klonovvladimir/hydrodrive_pcb/outputs/BOM/BOM pirnt.xlsx

Designator | Part Name | Parameters
BUT1_1, BUT1_2, BUT1_3, BUT1_4, BUT1_5, BUT1_6 | Тактовая кнопка KLS7-TS6604-4.3-180 | 4.3мм | 6
C1, C4, C5, C6, C7, C12, C14, C17, C22, C28, C30_1, C30_2, C34, C36, C37, C40, C41, C44, C45, C46, C47 | Конд-р керам. 0805, 0u1, 50V | 0u1, 50V | 21
C2, C3 | Конд-р керам. 0805, 15p, 50V | 15p, 50V | 2
C8, C20, C21, C43 | Конд-р керам. 0805, 10u, 16V | 10u, 16V | 4
C9, C11 | Конд-р керам. 0805, 1u, 50V | 1u, 50V | 2
C10 | Конд-р керам. 0805, 0u01, 50V | 0u01, 50V | 1
C13, C27, C29 | Конд-р электрол. JRB1H471M05001000200000B, 470uF, 50V | 470uF, 50V | 3
C15, C18 | Конд-р керам. 0805, 15n, 50V | 15n, 50V | 2
C16, C19 | Конд-р электрол. JRK1A221M02500630070000B, 220uF, 10V | 220uF, 10V | 2
C23, C25, C31_1, C31_2 | Конд-р электрол. TKR101M1HF11, 100uF, 50V | 100uF, 50V | 4
C24, C26 | Конд-р керам. 1206, 0u1, 50V | 0u1, 50V | 2
C32_1, C32_2, C33_1, C33_2, C33_3, C33_4, C33_5, C33_6, C39_1, C39_2 | Конд-р керам. 0805, 10n, 50V | 10n, 50V | 10
C42 | Конд-р керам. 0805, 1n, 50V | 1n, 50V | 1
C48 | Конд-р керам. 0805, 1n5, 50V | 1n5, 50V | 1
D1, D2, D9 | Диод Шоттки SK56 | 60V, 5A | 3
D3_1, D3_2, D3_3, D3_4, D3_5, D3_6, D15 | Оптопара транзисторная LTV-817S |  | 7
D4, D7 | Диод Шоттки SS24 | 40V, 2A | 2
D5, D8 | Защитный диод SMAJ12A | 12V, 400W | 2
D6 | MOSFET драйвер FAN3224TMX | 4.5..18V, 5A, LL | 1
D10_1, D10_2 | Передатчик 4-20mA AD694ARZ |  | 2
D11_1, D11_2, D12_1, D12_2, D12_3, D12_4, D12_5, D12_6, D16_1, D16_2 | Защитный диод SMBJ3V3-E3/52 | 3V3, 600W | 10
D13 | Микросхема SP3485EN-L/TR | 3V3 | 1
D14 | Микросхема CA-IF1051VS-Q1 | CAN | 1
D17, D18 | Микросхема ADM3490 | 3V3 | 2
D19 | Микросхема P82B715TD | I2C | 1
D20 | Диод Шоттки MBR0540 | 40V, 0.5A | 1
DL1, DL2, DL3, DL4 | Светодиод smd 0805 | Желтый | 4
J1, J4, J5, J6, J10_1, J10_2, J10_3, J10_4, J10_5, J10_6, J15 | Клеммник DG142V-5.08-02P | 8А | 11
J2, J11, J13, J17 | Клеммник DG142V-5.08-03P | 8А | 4
J7, J18, J19, J20, J21, J24, J25 | Разъем PLS-2, шаг 2.54 мм | 2.54 мм | 7
J8 | Разъем PBD-8R, шаг 2.54 мм | 2.54 мм | 1
J9_1, J9_2 | Клеммник DG142V-5.08-06P | 8А | 2
J12, J14, J16_1, J16_2, J22 | Клеммник DG142V-5.08-04P | 8А | 5
J23 | Клеммник DG142V-5.08-08P | 8А | 1
L1 | Индуктивность smd 0805 | 1u, 100mA | 1
L2, L3, L4 | Индуктивность IHLP4040DZER470M11 | 47uH | 3
M1 | Программатор ST-LINK/V2 (mini) Waveshare 10053 |  | 1
OA1 | Операционный усилитель LMV358IDR |  | 1
R1 | Рез-р 0805, 0R, 5% | 0R, 5% | 1
R2, R5, R24_1, R24_2 | Рез-р 0805, 30k, 5% | 30k, 5% | 4
R3, R7_1, R7_2, R7_3, R7_4, R7_5, R7_6, R8_1, R8_2, R8_3, R8_4, R8_5, R8_6, R9, R12, R13, R14, R17, R18, R19, R25_1, R25_2, R33, R35, R36, R38, R39, R41, R45, R46, R47, R48, R49, R50 | Рез-р 0805, 10k, 5% | 10k, 5% | 34
R6 | Рез-р 0805, 18k, 5% | 18k, 5% | 1
R10, R11 | Рез-р 0805, 18R, 5% | 18R, 5% | 2
R15 | Рез-р 1206, 4k7, 5% | 4k7, 5% | 1
R16 | Рез-р 2512, 0R1, 5% | 0R1, 5% | 1
R20, R22 | Рез-р 0805, 510R, 5% | 510R, 5% | 2
R21, R23 | Рез-р 0805, 51k, 5% | 51k, 5% | 2
R26_1, R26_2, R27_1, R27_2, R27_3, R27_4, R27_5, R27_6, R37_1, R37_2 | Рез-р 0805, 120R, 1% | 120R, 1% | 10
R28, R30, R51, R52 | Рез-р 1206, 680R, 5% | 680R, 5% | 4
R29, R32, R53 | Рез-р 1206, 120R, 5% | 120R, 5% | 3
R31, R34 | Рез-р 1206, 0R, 5% | 0R, 5% | 2
R40 | Рез-р 0805, 1k5, 5% | 1k5, 5% | 1
R43 | Рез-р 0805, 15k, 5% | 15k, 5% | 1
R44, R54, R57 | Рез-р 0805, 1k, 5% | 1k, 5% | 3
R55, R56, R58, R59, R60, R61, R62, R63 | Рез-р 0805, 4k7, 5% | 4k7, 5% | 8
R64, R65 | Рез-р 0805, 470R, 5% | 470R, 5% | 2
R68 | Рез-р 0805, 22k, 5% | 22k, 5% | 1
U1 | STM32G474RET6 |  | 1
U2, U3, U5L60B60A60:R6A60:F60 | DC-DC преобразователь LM2596S-ADJ | 40V, 1.23..37V, 3A, 150kHz | 3
U4 | Линейный регулятор LM1117MPX-3.3/NOPB | 3.3V, 800mA | 1
U6, U7, U9, U10, U11, U12 | Диодная сборка USBLC6-2SC6 | 5.25V | 6
U8 | Микросхема REF192GSZ | 2.5V, 0.4% | 1
VT1, VT2 | Транзистора 20N06 | 60V, 20A | 2
VT3, VT4, VT5 | Транзистор BC817 | 45V, 0.5A | 3
VT6 | Транзистор BC807 | 45V, 0.5A | 1
ZQ1 | Кварц. Рез-р HC-49S, 12MHz | 12MHz | 1
