klonovvladimir/hydrodrive_pcb/outputs/BOM/Bill of Materials-gydrodrive_control_board.xlsx

Part Name | Comment | Description | Designator | Parameters | Quantity
 | STM32G474RETx | Mainstream Arm Cortex-M4 core with DSP and FPU, 170MHz with 512Kbytes of Flash memory, Math Accelerator, HR Timer, High Analog level integration | U1 |  | 1
DC-DC преобразователь LM2596S-ADJ | LM2596S-ADJ | DC-DC преобразователь | U2, U3, U5 | 40V, 1.23..37V, 3A, 150kHz | 3
MOSFET драйвер FAN3224TMX | FAN3224TMX | Сдвоенный драйвер ключей нижнего уровня | D6 | 4.5..18V, 5A, LL | 1
Диод Шоттки MBR0540 | MBR0540 | Диод Шоттки | D20 | 40V, 0.5A | 1
Диод Шоттки SK56 | SK56 | Диод Шоттки | D1, D2, D9 | 60V, 5A | 3
Диод Шоттки SS24 | SS24 | Диод Шоттки | D4, D7 | 40V, 2A | 2
Диодная сборка USBLC6-2SC6 | USBLC6-2SC6 | Диодная сборка для защиты дифференциальной линии | U6, U7, U9, U10, U11, U12 | 5.25V | 6
Защитный диод SMAJ12A | SMAJ12A | Защитный диод (TVS) | D5, D8 | 12V, 400W | 2
Защитный диод SMBJ3V3-E3/52 | SMBJ3V3-E3/52 | Защитный диод (TVS) | D11_1, D11_2, D12_1, D12_2, D12_3, D12_4, D12_5, D12_6, D16_1, D16_2 | 3V3, 600W | 10
Индуктивность IHLP4040DZER470M11 | IHLP4040DZER470M11 | Индуктивность силовая | L2, L3, L4 | 47uH | 3
Индуктивность smd 0805 | IND_0805 | Индуктивность, корпус 0805 | L1 | 1u, 100mA | 1
Кварц. Рез-р HC-49S, 12MHz | QRZ_HC_49_SMD | Кварцевый резонатор в корпусе HC-49 SMD | ZQ1 | 12MHz | 1
Клеммник DG142V-5.08-02P | DG142V-5.08-02P | Клеммник 2-контактный, шаг 5.08 мм | J1, J3_1, J3_2, J3_3, J3_4, J3_5, J3_6, J4, J5, J6, J10_1, J10_2, J10_3, J10_4, J10_5, J10_6, J15 | 8А | 17
Клеммник DG142V-5.08-03P | DG142V-5.08-03P | Клеммник 3-контактный, шаг 5.08 мм | J2, J11, J13, J17 | 8А | 4
Клеммник DG142V-5.08-04P | DG142V-5.08-04P | Клеммник 4-контактный, шаг 5.08 мм | J12, J14, J16_1, J16_2, J22 | 8А | 5
Клеммник DG142V-5.08-06P | DG142V-5.08-06P | Клеммник 6-контактный, шаг 5.08 мм | J9_1, J9_2 | 8А | 2
Клеммник DG142V-5.08-08P | DG142V-5.08-08P | Клеммник 8-контактный, шаг 5.08 мм | J23 | 8А | 1
Конд-р керам. 0805, 0u1, 50V | CAP_0805 | Конденсатор керамический, корпус 0805 | C1, C4, C5, C6, C7, C12, C14, C17, C22, C28, C30_1, C30_2, C34, C36, C37, C40, C41, C44, C45, C46, C47 | 0u1, 50V | 21
Конд-р керам. 0805, 0u01, 50V | CAP_0805 | Конденсатор керамический, корпус 0805 | C10 | 0u01, 50V | 1
Конд-р керам. 0805, 1n5, 50V | CAP_0805 | Конденсатор керамический, корпус 0805 | C48 | 1n5, 50V | 1
Конд-р керам. 0805, 1n, 50V | CAP_0805 | Конденсатор керамический, корпус 0805 | C42 | 1n, 50V | 1
Конд-р керам. 0805, 1u, 50V | CAP_0805 | Конденсатор керамический, корпус 0805 | C9, C11 | 1u, 50V | 2
Конд-р керам. 0805, 10n, 50V | CAP_0805 | Конденсатор керамический, корпус 0805 | C32_1, C32_2, C33_1, C33_2, C33_3, C33_4, C33_5, C33_6, C39_1, C39_2 | 10n, 50V | 10
Конд-р керам. 0805, 10u, 16V | CAP_0805 | Конденсатор керамический, корпус 0805 | C8, C20, C21, C43 | 10u, 16V | 4
Конд-р керам. 0805, 15n, 50V | CAP_0805 | Конденсатор керамический, корпус 0805 | C15, C18 | 15n, 50V | 2
Конд-р керам. 0805, 15p, 50V | CAP_0805 | Конденсатор керамический, корпус 0805 | C2, C3 | 15p, 50V | 2
Конд-р керам. 1206, 0u1, 50V | CAP_1206 | Конденсатор керамический, корпус 1206 | C24, C26 | 0u1, 50V | 2
Конд-р керам. 1206, 4n7, 50V | CAP_1206 | Конденсатор керамический, корпус 1206 | C35, C38 | 4n7, 50V | 2
Конд-р электрол. JRB1H471M05001000200000B, 470uF, 50V | JRB1H471M05001000200000B | Конденсатор электролитический | C13, C27, C29 | 470uF, 50V | 3
Конд-р электрол. JRK1A221M02500630070000B, 220uF, 10V | JRK1A221M02500630070000B | Конденсатор электролитический | C16, C19 | 220uF, 10V | 2
Конд-р электрол. TKR101M1HF11, 100uF, 50V | TKR101M1HF11 | Конденсатор электролитический | C23, C25, C31_1, C31_2 | 100uF, 50V | 4
Линейный регулятор LM1117MPX-3.3/NOPB | LM1117MPX-3.3/NOPB | Линейный регулятор с низким падением напряжения | U4 | 3.3V, 800mA | 1
Микросхема ADM3490 | ADM3490 | Дифференциальный приемопередатчик rs422 | D17, D18 | 3V3 | 2
Микросхема CA-IF1051VS-Q1 | CA-IF1051VS-Q1 | CAN интерфейс | D14 | CAN | 1
Микросхема P82B715TD | P82B715TD | Расширитель порта I2C | D19 | I2C | 1
Микросхема REF192GSZ | REF192GSZ | Источник опорного напряжения, 2.5 В | U8 | 2.5V, 0.4% | 1
Микросхема SP3485EN-L/TR | SP3485EN-L/TR | Дифференциальный приемопередатчик rs485 | D13 | 3V3 | 1
Операционный усилитель LMV358IDR | LMV358IDR | Операционный усилитель RTR, маломощный, 2 канала | OA1 |  | 1
Оптопара транзисторная LTV-817S | LTV-817S | Оптопара транзисторная одноканальная | D3_1, D3_2, D3_3, D3_4, D3_5, D3_6, D15 |  | 7
Передатчик 4-20mA AD694ARZ | AD694ARZ |  | D10_1, D10_2 |  | 2
Программатор ST-LINK/V2 (mini) Waveshare 10053 | ST-LINK/V2 | Программатор | M1 |  | 1
Разъем PBD-8R, шаг 2.54 мм | PBD-2.54-08R | Разъем | J8 | 2.54 мм | 1
Разъем PLS-2, шаг 2.54 мм | PLS-2.54-2 JUMP | Разъем штыревой шаг 2.54 мм | J7, J18, J19, J20, J21, J24, J25 | 2.54 мм | 7
Рез-р 0805, 0R, 5% | RES_0805 | Рез-р, корпус 0805 | R1, R4, R42, R66, R67 | 0R, 5% | 5
Рез-р 0805, 1k5, 5% | RES_0805 | Рез-р, корпус 0805 | R40 | 1k5, 5% | 1
Рез-р 0805, 1k, 5% | RES_0805 | Рез-р, корпус 0805 | R44, R54, R57 | 1k, 5% | 3
Рез-р 0805, 4k7, 5% | RES_0805 | Рез-р, корпус 0805 | R55, R56, R58, R59, R60, R61, R62, R63 | 4k7, 5% | 8
Рез-р 0805, 10k, 5% | RES_0805 | Рез-р, корпус 0805 | R3, R7_1, R7_2, R7_3, R7_4, R7_5, R7_6, R8_1, R8_2, R8_3, R8_4, R8_5, R8_6, R9, R12, R13, R14, R17, R18, R19, R25_1, R25_2, R33, R35, R36, R38, R39, R41, R45, R46, R47, R48, R49, R50 | 10k, 5% | 34
Рез-р 0805, 15k, 5% | RES_0805 | Рез-р, корпус 0805 | R43 | 15k, 5% | 1
Рез-р 0805, 18k, 5% | RES_0805 | Рез-р, корпус 0805 | R6 | 18k, 5% | 1
Рез-р 0805, 18R, 5% | RES_0805 | Рез-р, корпус 0805 | R10, R11 | 18R, 5% | 2
Рез-р 0805, 22k, 5% | RES_0805 | Рез-р, корпус 0805 | R68 | 22k, 5% | 1
Рез-р 0805, 30k, 5% | RES_0805 | Рез-р, корпус 0805 | R2, R5, R24_1, R24_2 | 30k, 5% | 4
Рез-р 0805, 51k, 5% | RES_0805 | Рез-р, корпус 0805 | R21, R23 | 51k, 5% | 2
Рез-р 0805, 120R, 1% | RES_0805 | Рез-р, корпус 0805 | R26_1, R26_2, R27_1, R27_2, R27_3, R27_4, R27_5, R27_6, R37_1, R37_2 | 120R, 1% | 10
Рез-р 0805, 470R, 5% | RES_0805 | Рез-р, корпус 0805 | R64, R65 | 470R, 5% | 2
Рез-р 0805, 510R, 5% | RES_0805 | Рез-р, корпус 0805 | R20, R22 | 510R, 5% | 2
Рез-р 1206, 0R, 5% | RES_1206 | Рез-р, корпус 1206 | R31, R34 | 0R, 5% | 2
Рез-р 1206, 4k7, 5% | RES_1206 | Рез-р, корпус 1206 | R15 | 4k7, 5% | 1
Рез-р 1206, 120R, 5% | RES_1206 | Рез-р, корпус 1206 | R29, R32, R53 | 120R, 5% | 3
Рез-р 1206, 680R, 5% | RES_1206 | Рез-р, корпус 1206 | R28, R30, R51, R52 | 680R, 5% | 4
Рез-р 2512, 0R1, 5% | RES_2512 | Рез-р, корпус 2512 | R16 | 0R1, 5% | 1
Светодиод smd 0805 | LED_0805 | Светодиод smd, корпус 0805 | DL1, DL2, DL3, DL4 | Желтый | 4
Тактовая кнопка KLS7-TS6604-4.3-180 | KLS7-TS6604-4.3-180 | Тактовая кнопка SMD | BUT1_1, BUT1_2, BUT1_3, BUT1_4, BUT1_5, BUT1_6 | 4.3мм | 6
Транзистор BC807 | BC807 | Биполярный транзистор | VT6 | 45V, 0.5A | 1
Транзистор BC817 | BC817 | Биполярный транзистор | VT3, VT4, VT5 | 45V, 0.5A | 3
Транзистора 20N06 | 20N06 | Полевой транзистор | VT1, VT2 | 60V, 20A | 2
