klonovvladimir/hydrodrive_pcb/outputs/Схема/Схема электрическая.PDF

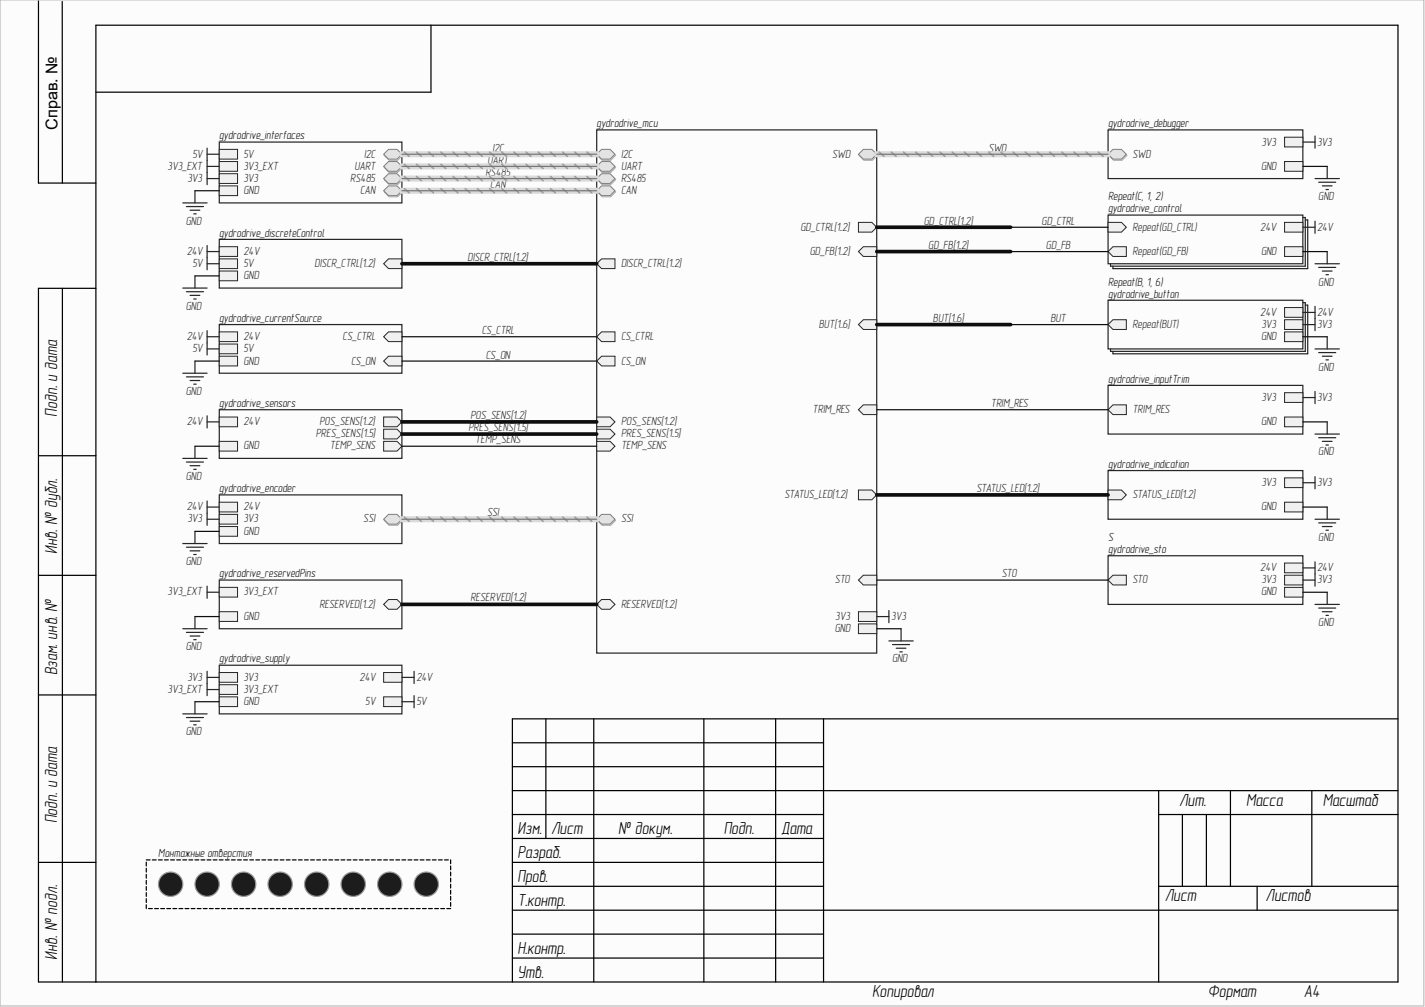
[picture p1: page 1]

Инв. № дубл. Подп. и дата

Инв. № подл. Подп. и дата Взам. инв. №

Лит. | Масса | Масштаб

Изм. | Лист | № докум. | Подп. | Дата
Разраб.
Пров.
Т.контр. | | | | | Лист | Листов

Н.контр.
Утв.

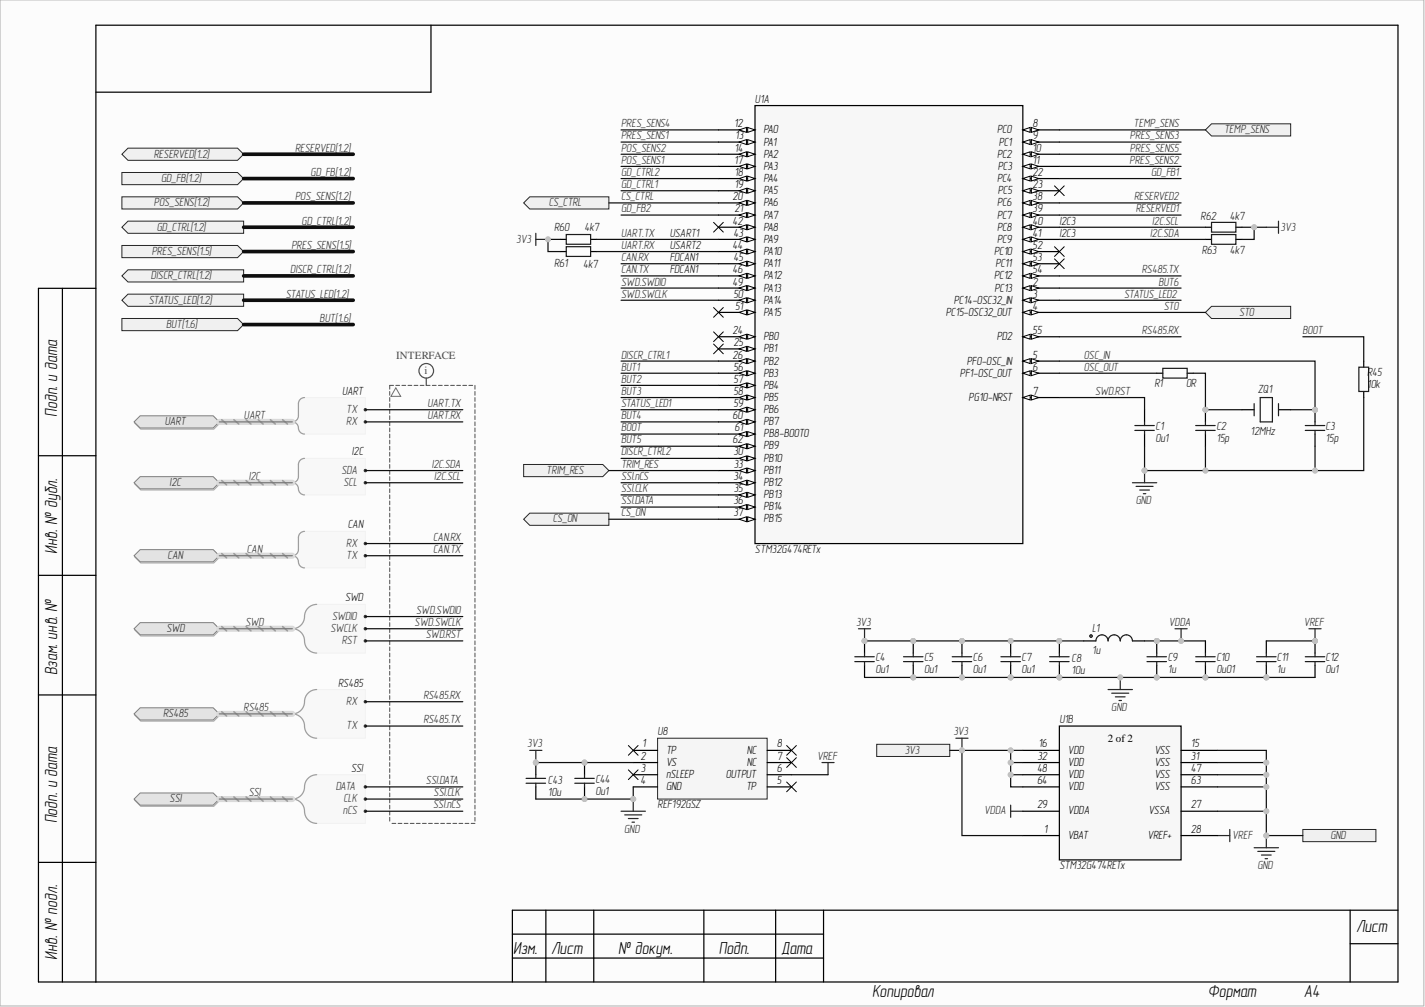
[picture p2: page 2]

Инв. № дубл. Подп. и дата

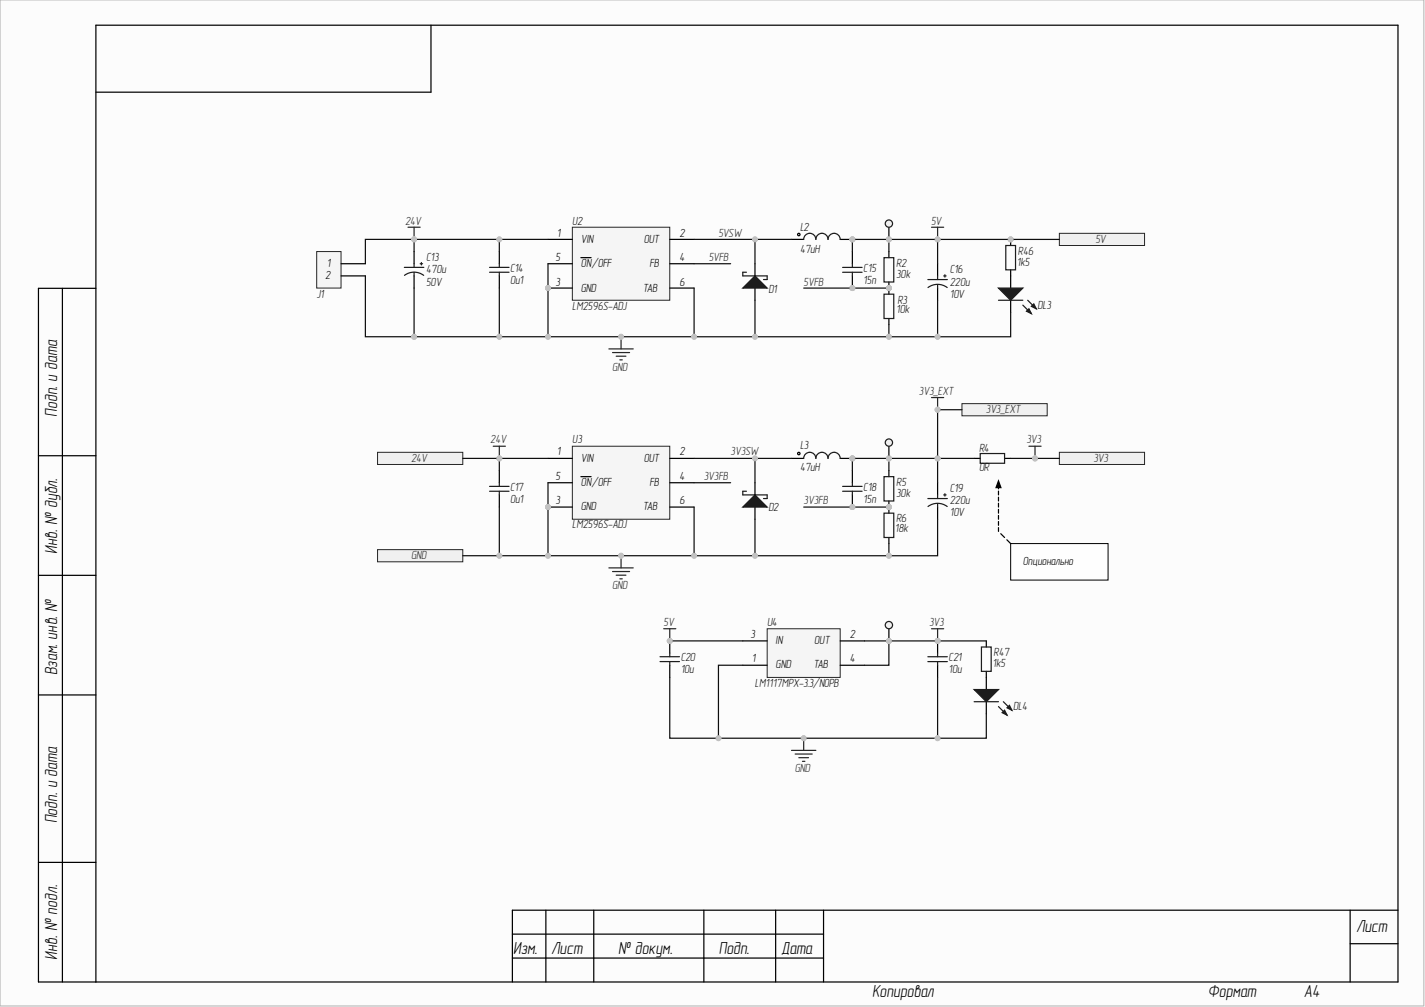
[picture p3: page 3]

Инв. № дубл. Подп. и дата

LM1117MPX-3.3/NOPB

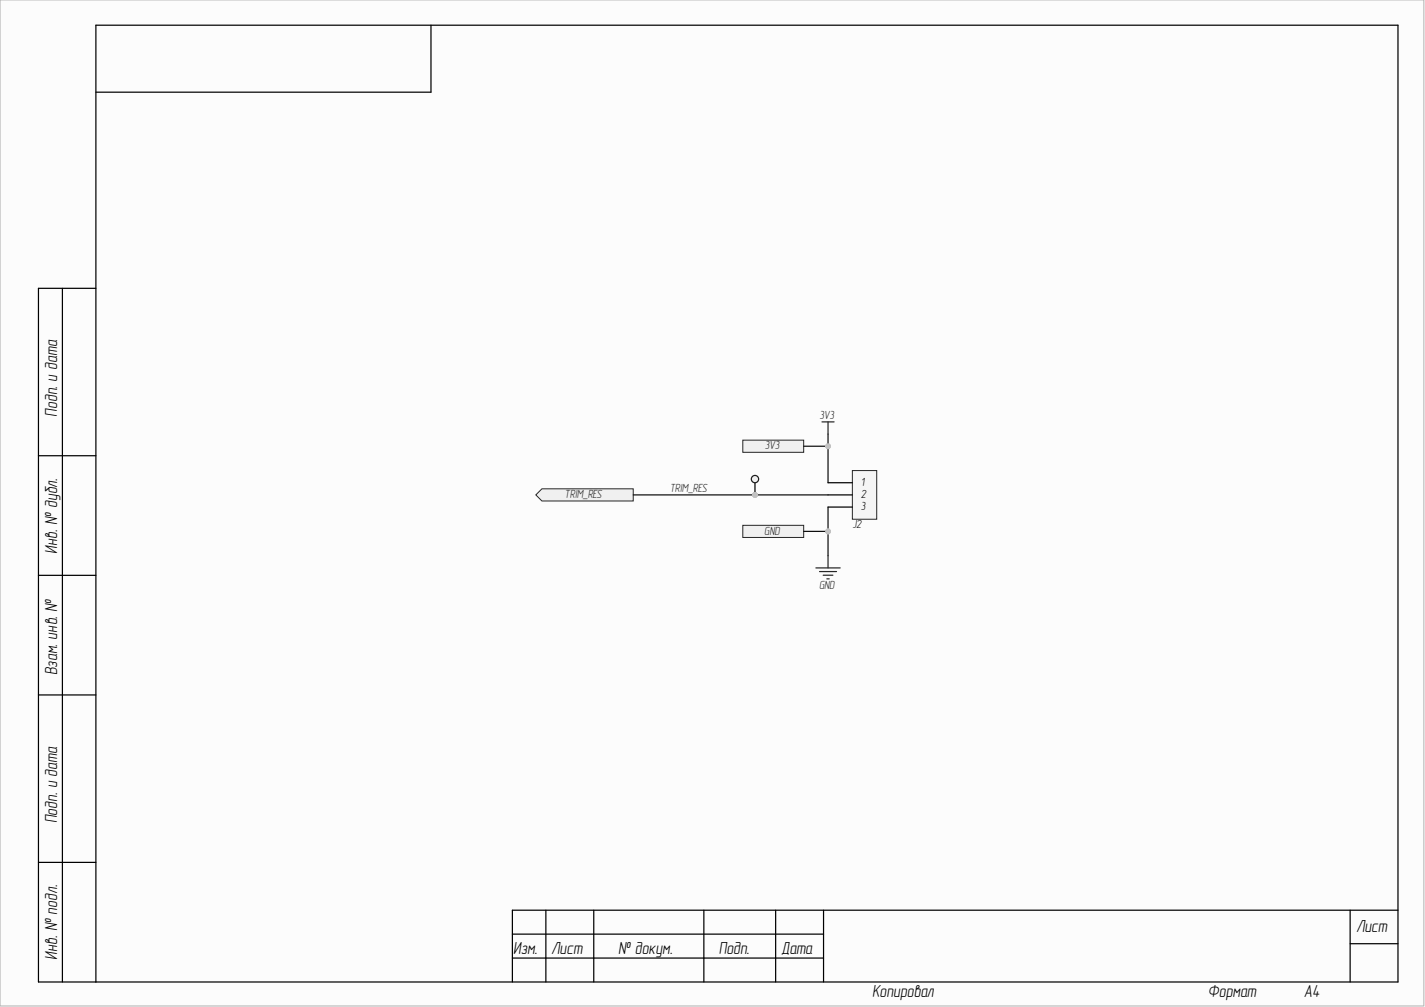
[picture p4: page 4]

Инв. № дубл. Подп. и дата

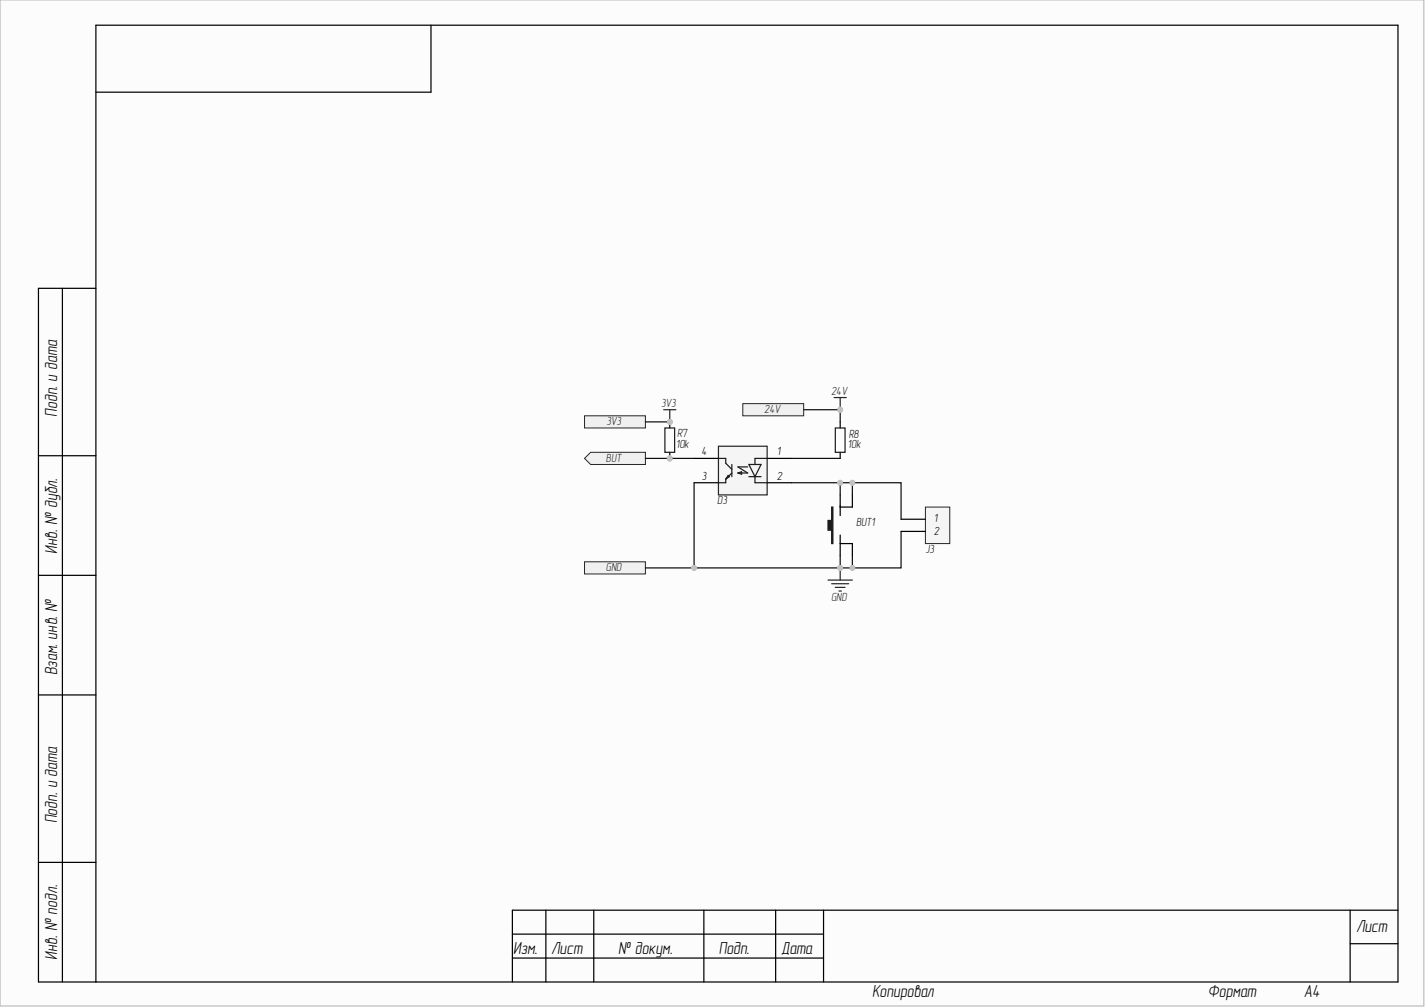
[picture p5: page 5]

Инв. № дубл. Подп. и дата

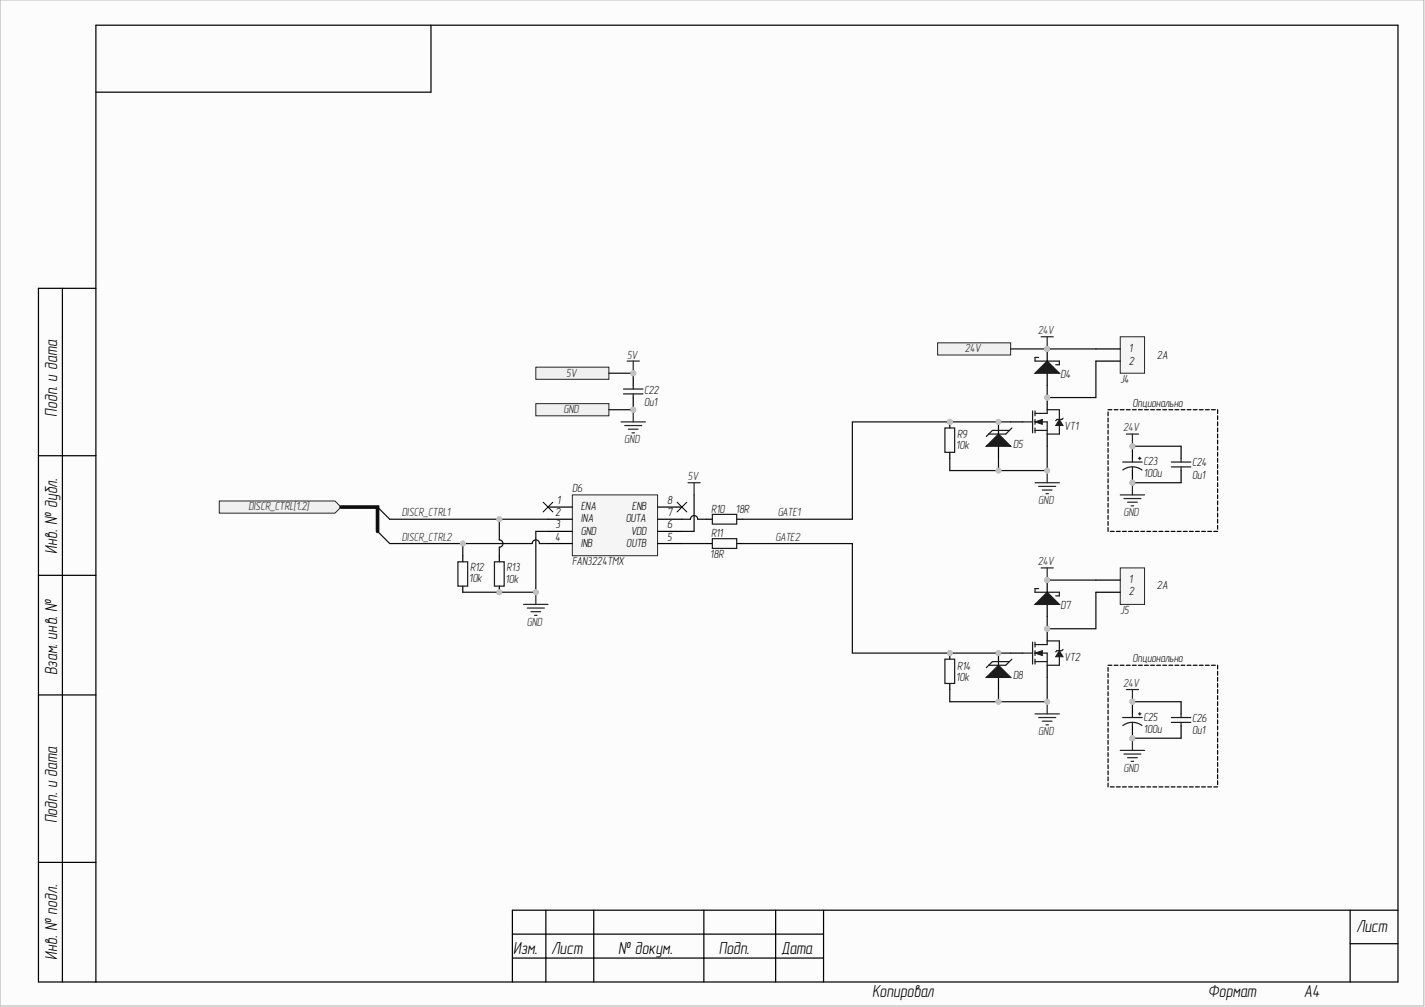
[picture p6: page 6]

Инв. № дубл. Подп. и дата

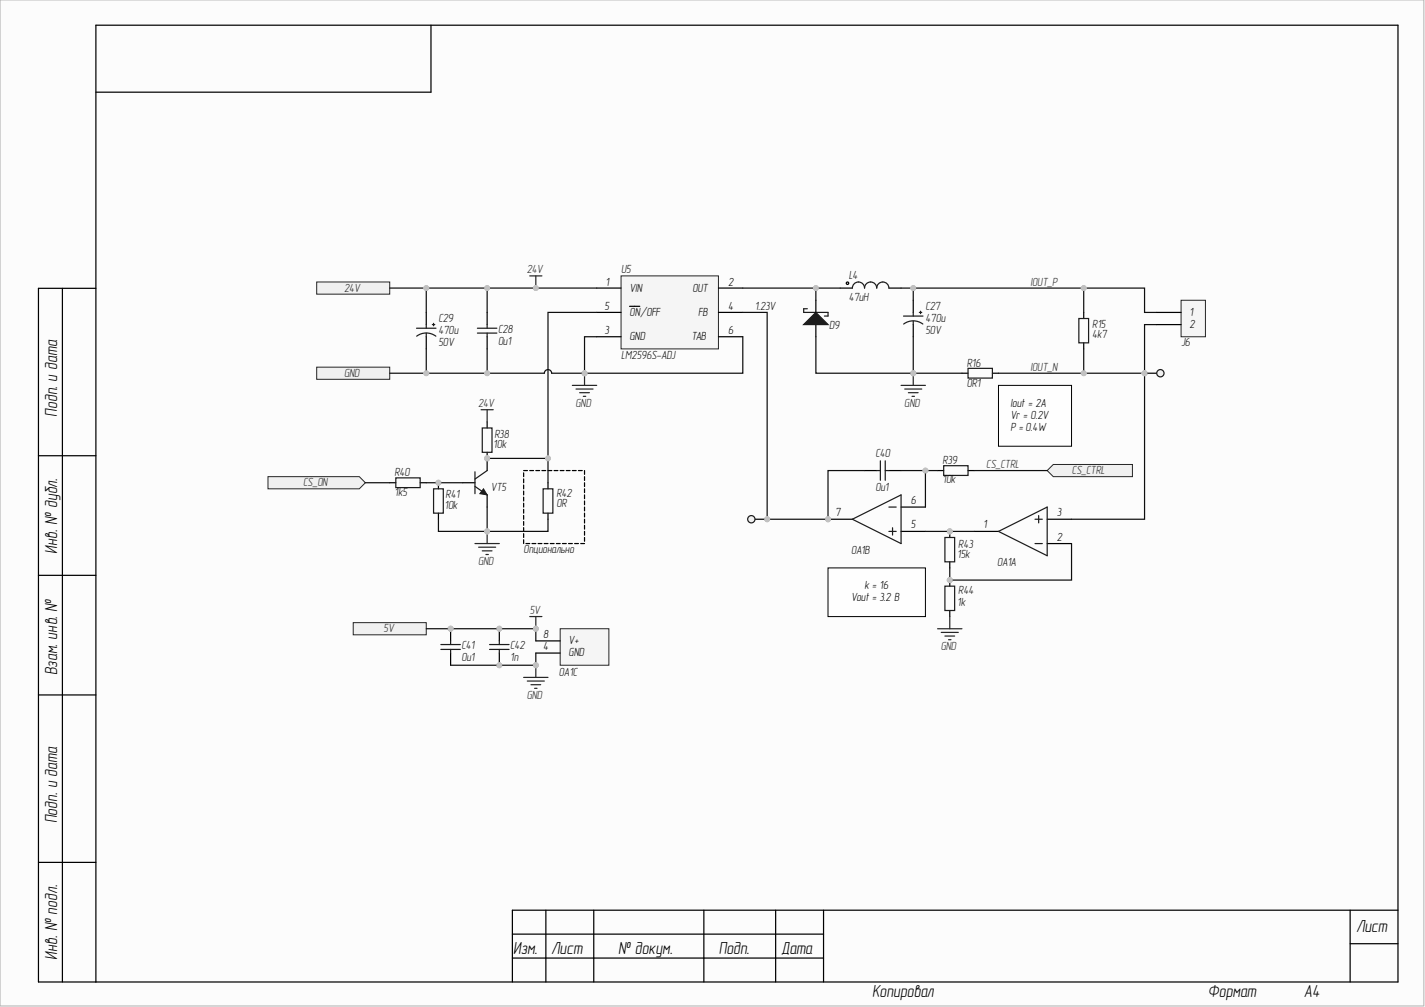
[picture p7: page 7]

Инв. № дубл. Подп. и дата

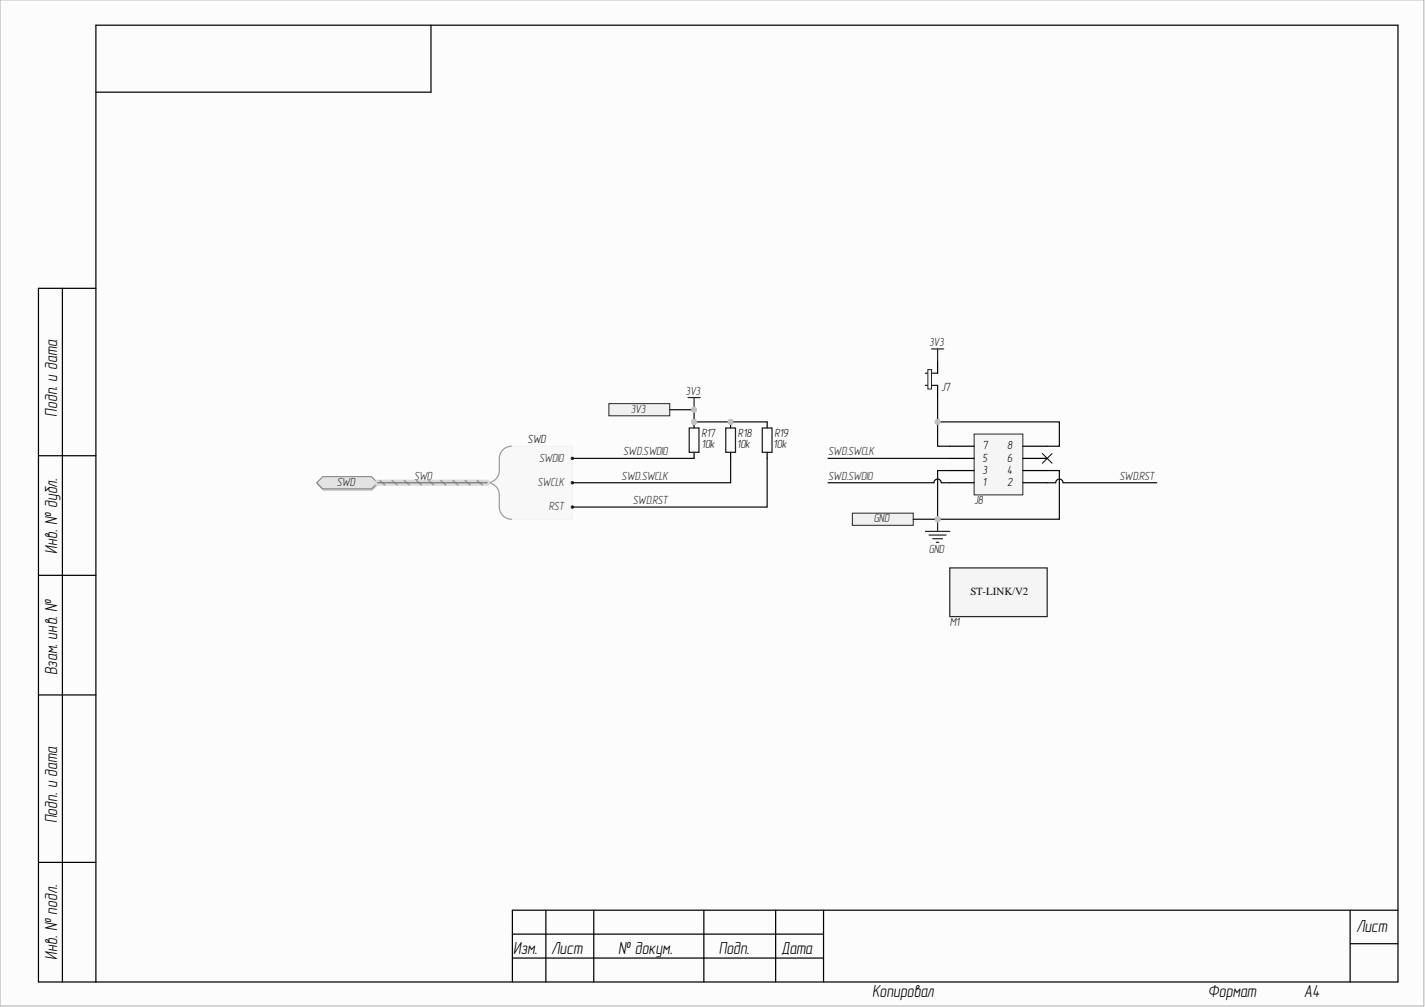
[picture p8: page 8]

Инв. № дубл. Подп. и дата

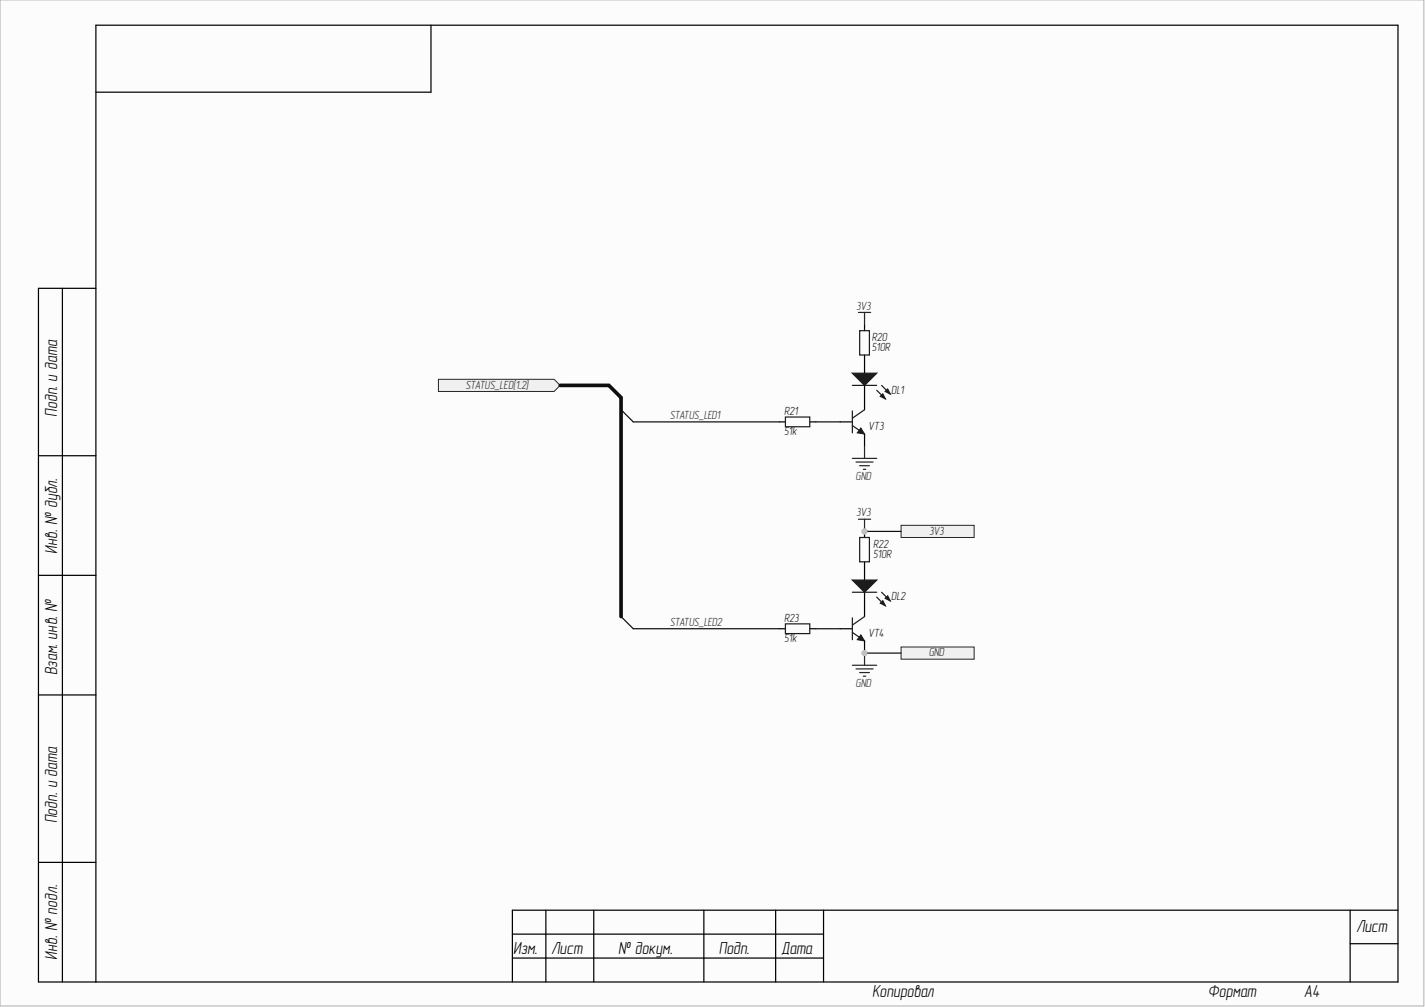
[picture p9: page 9]

Инв. № дубл. Подп. и дата

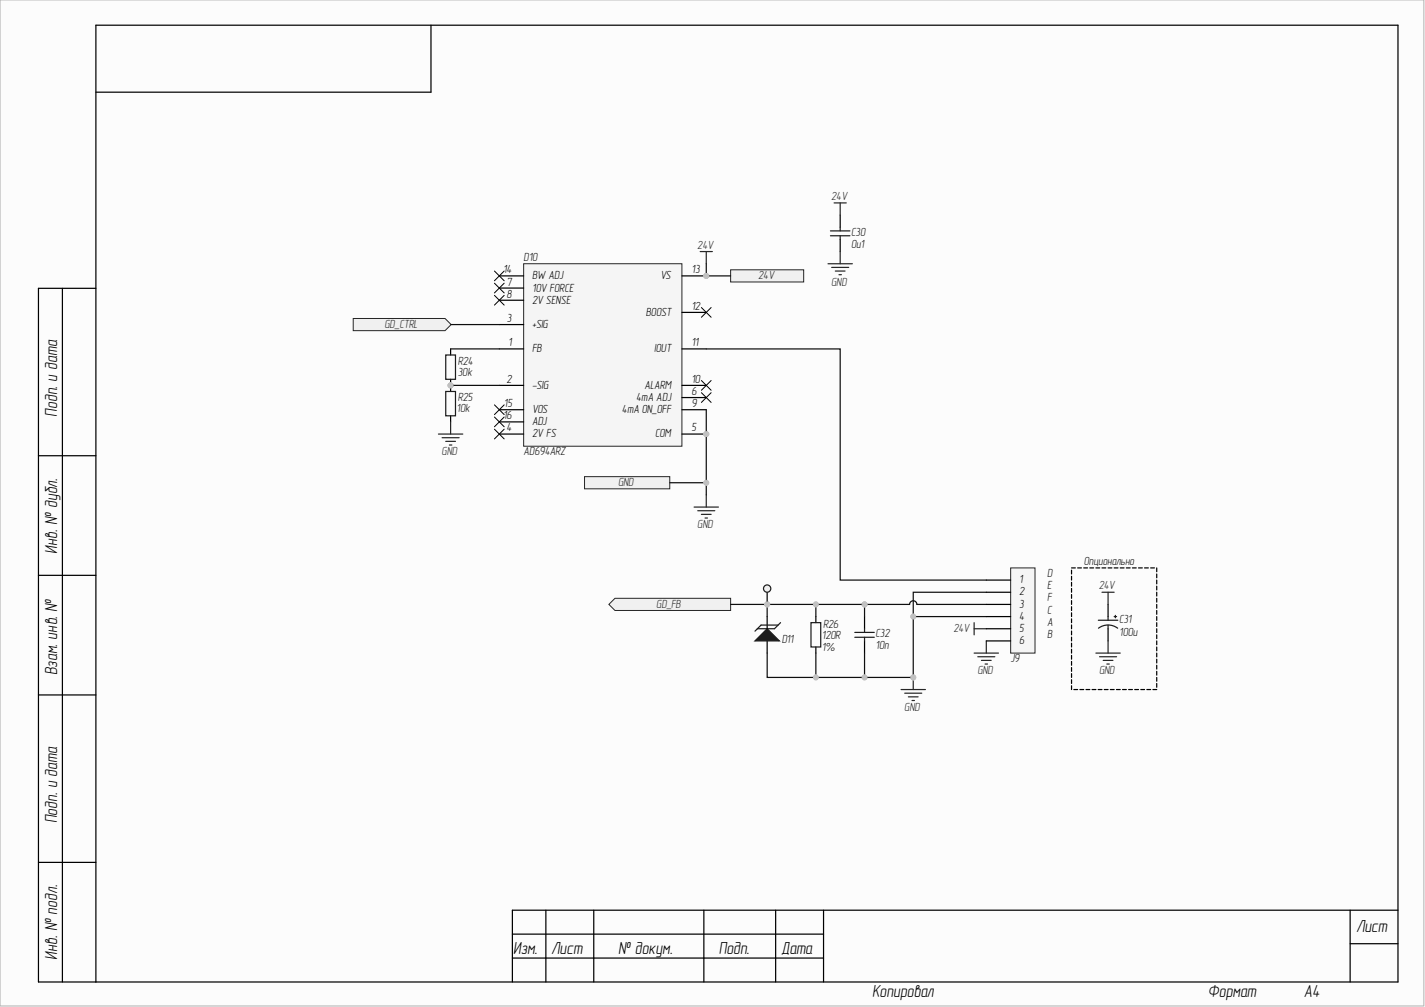
[picture p10: page 10]

Инв. № дубл. Подп. и дата

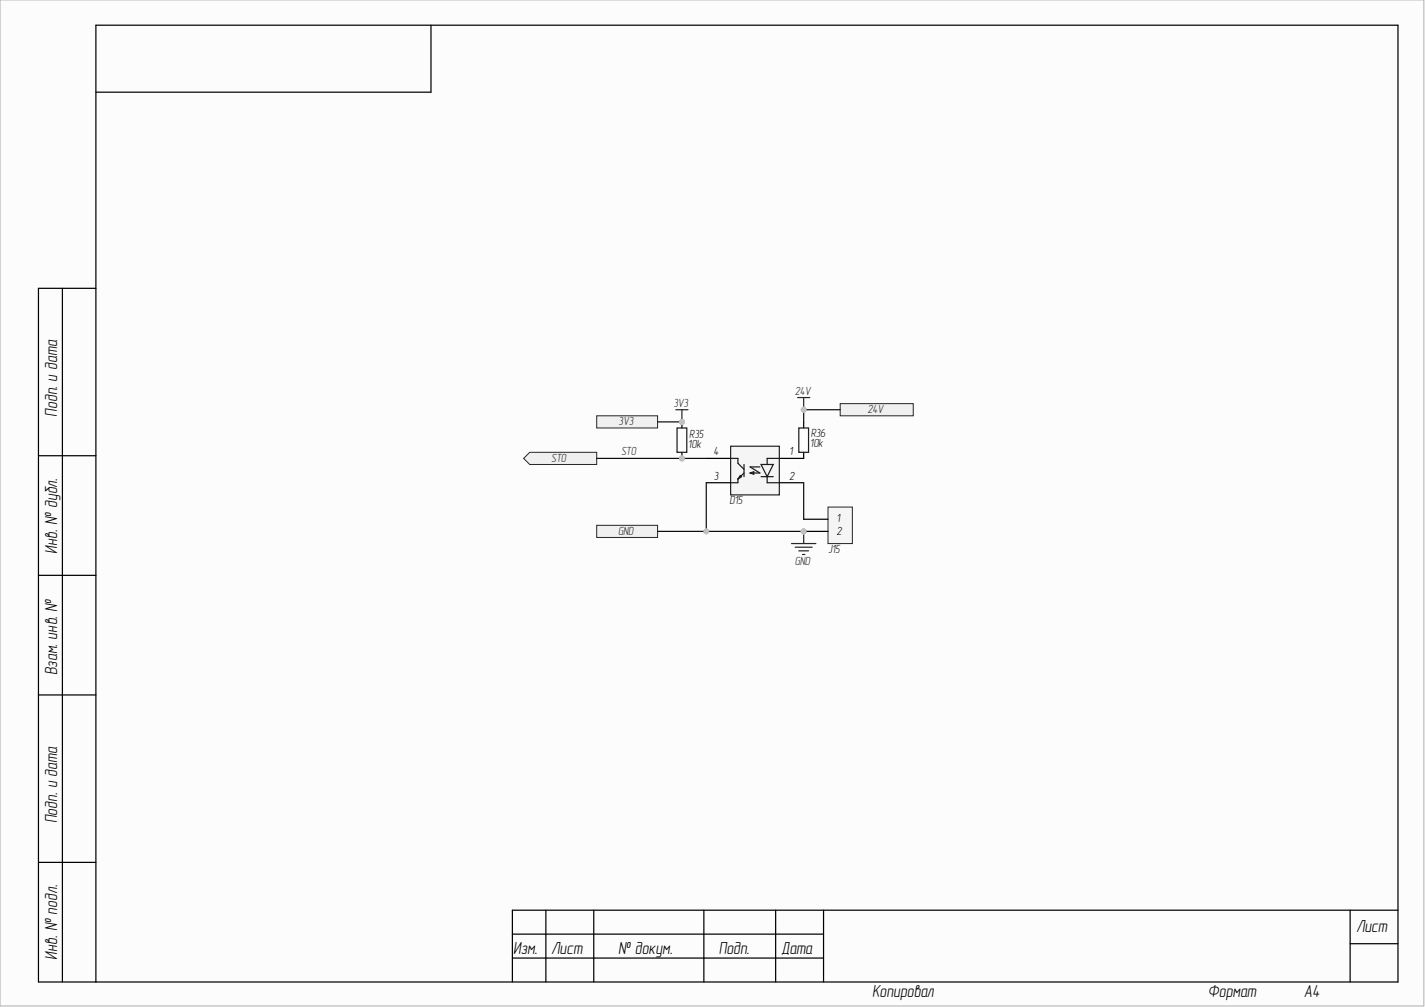
[picture p11: page 11]

Инв. № дубл. Подп. и дата

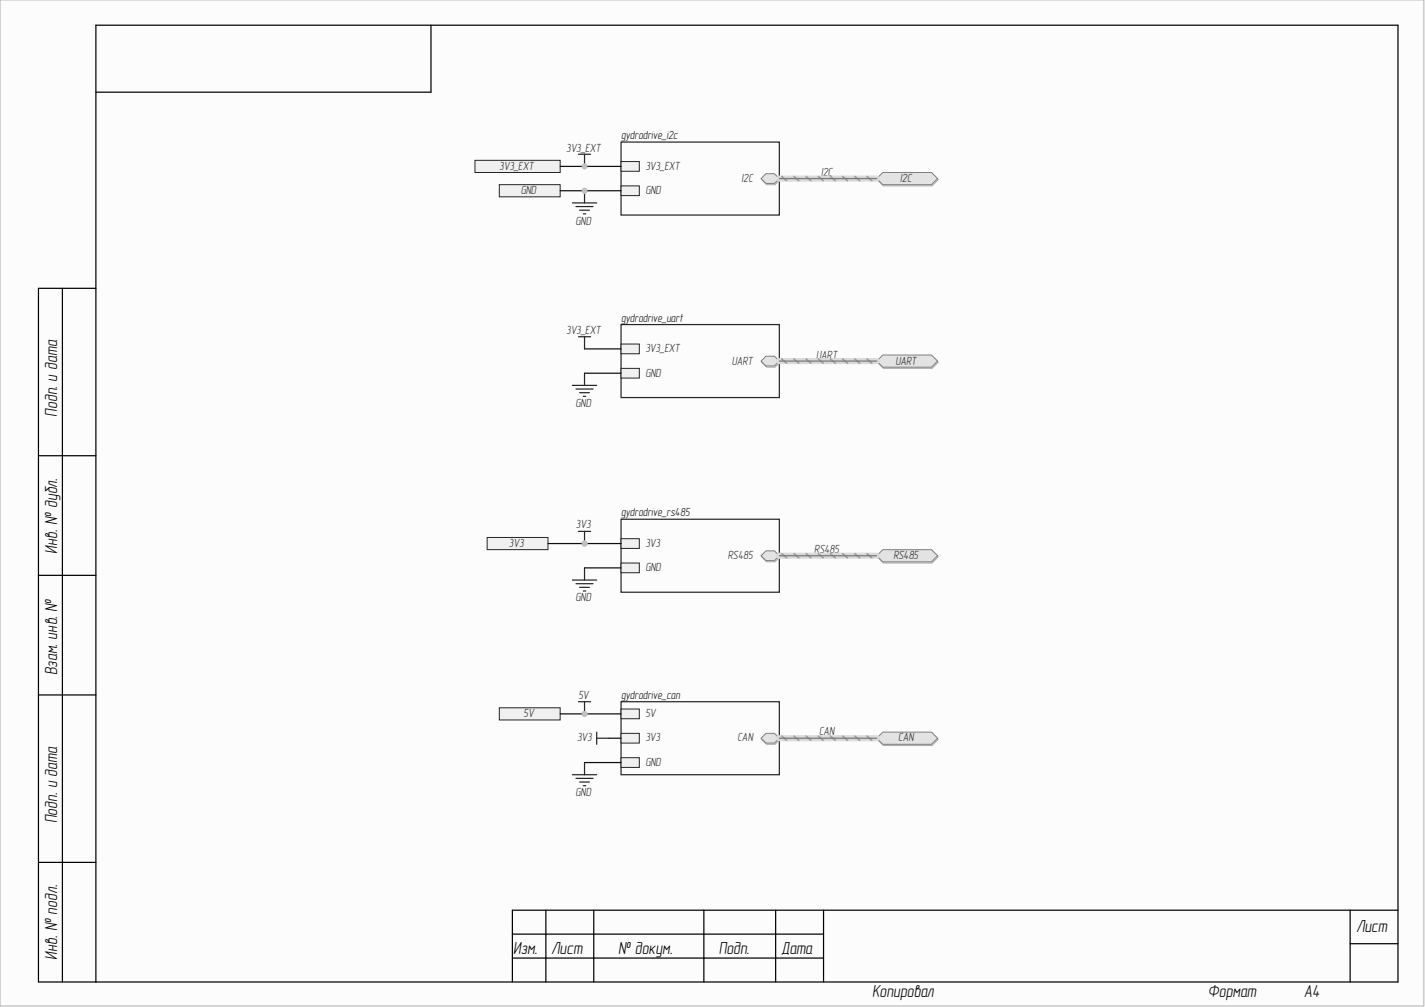
[picture p12: page 12]

Инв. № дубл. Подп. и дата

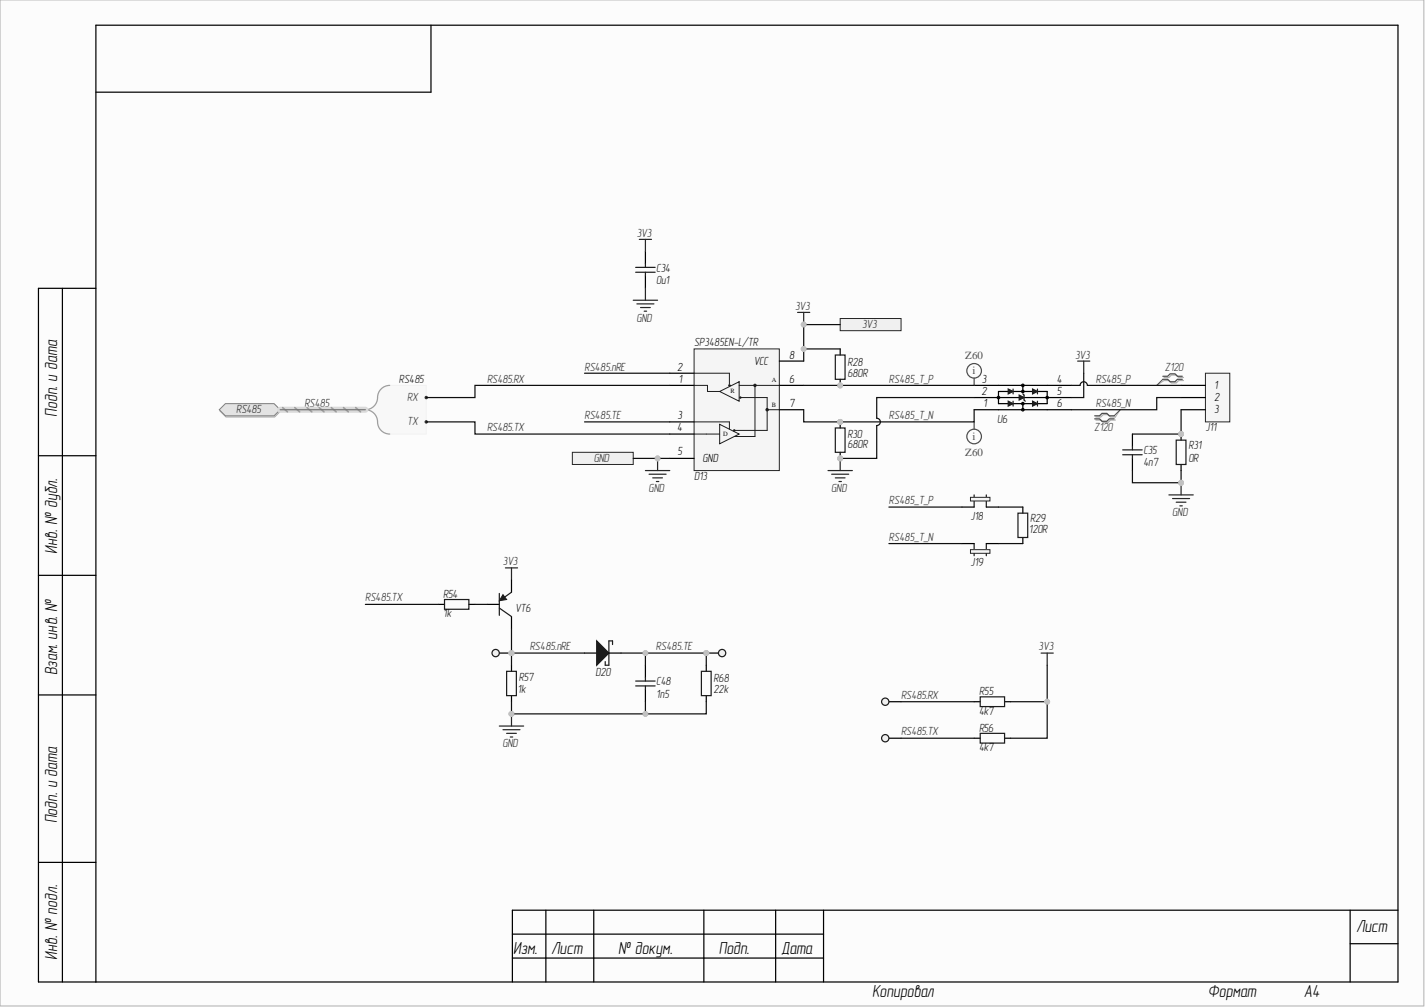
[picture p13: page 13]

Инв. № дубл. Подп. и дата

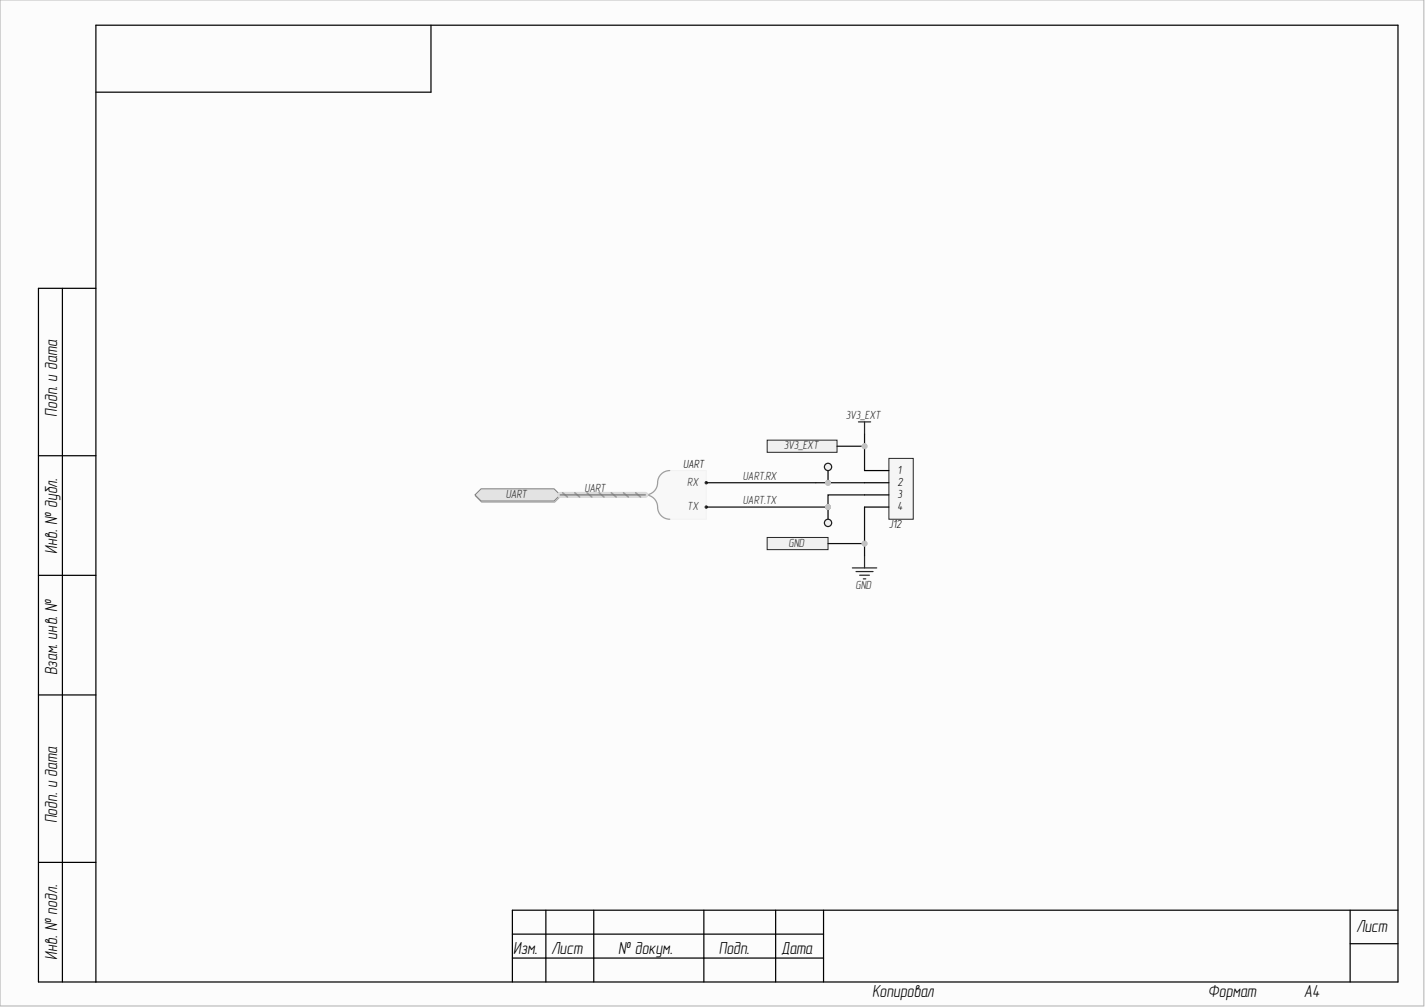
[picture p14: page 14]

Инв. № дубл. Подп. и дата

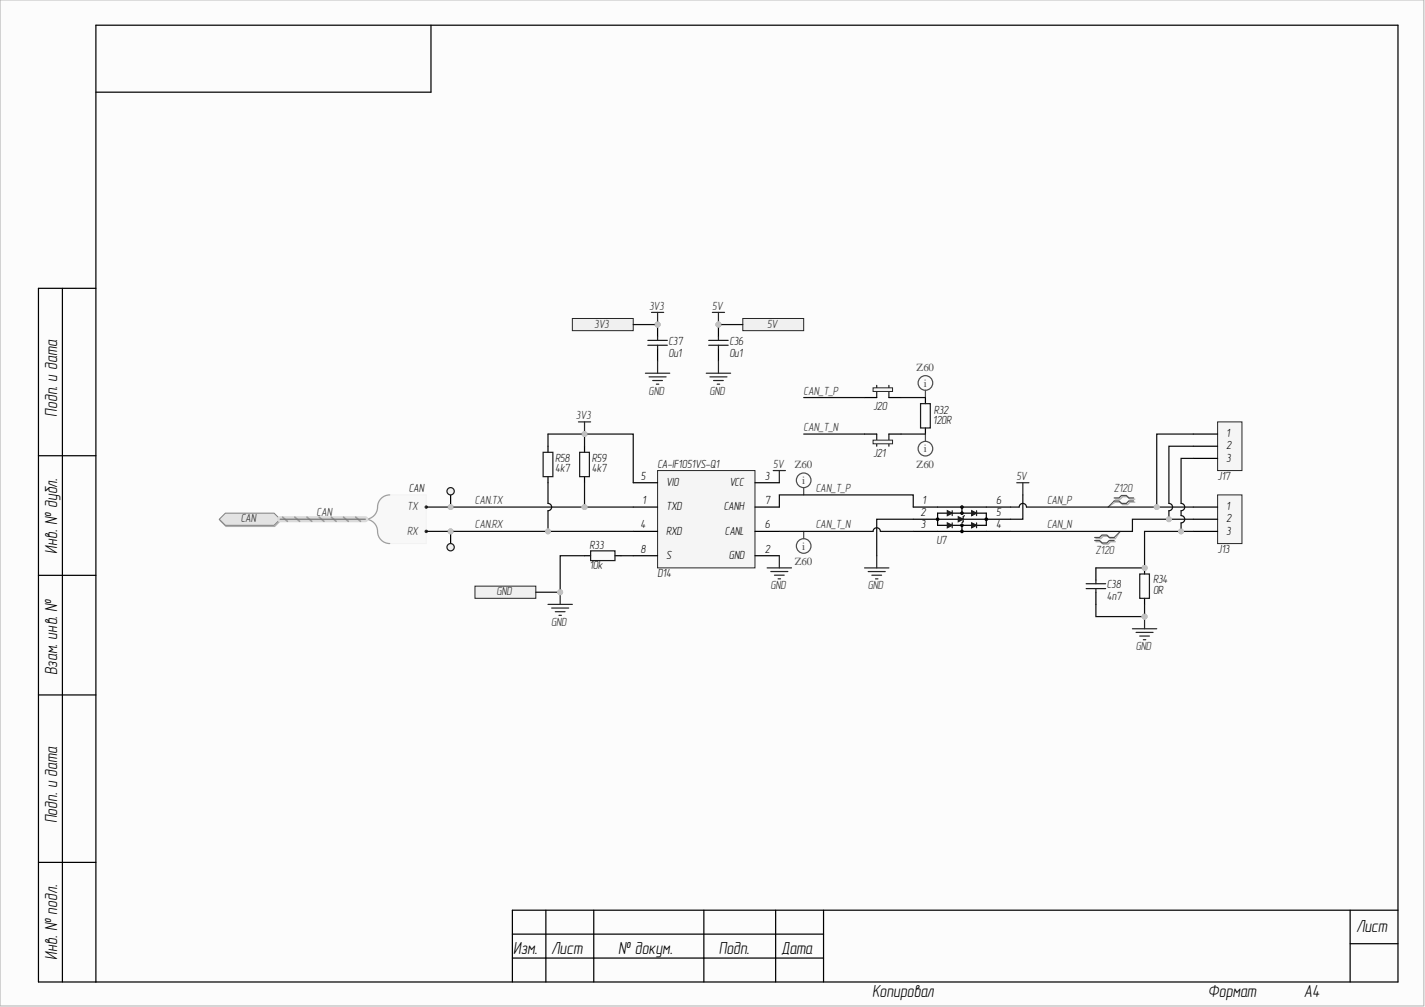
[picture p15: page 15]

Инв. № дубл. Подп. и дата

2 5
3 4 | CAN_N

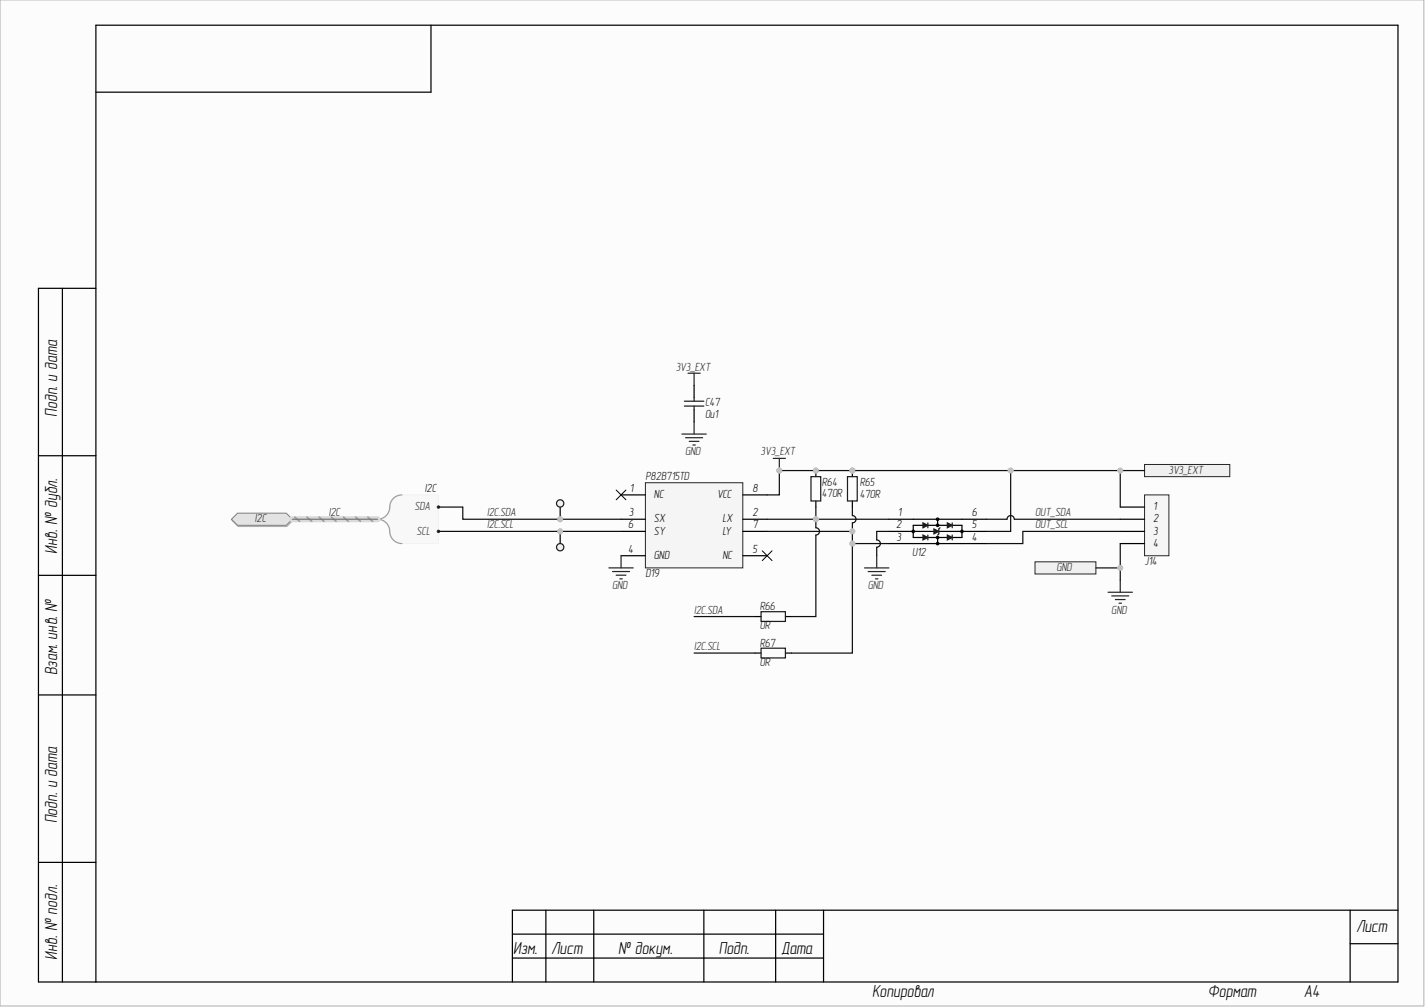
[picture p16: page 16]

Инв. № дубл. Подп. и дата

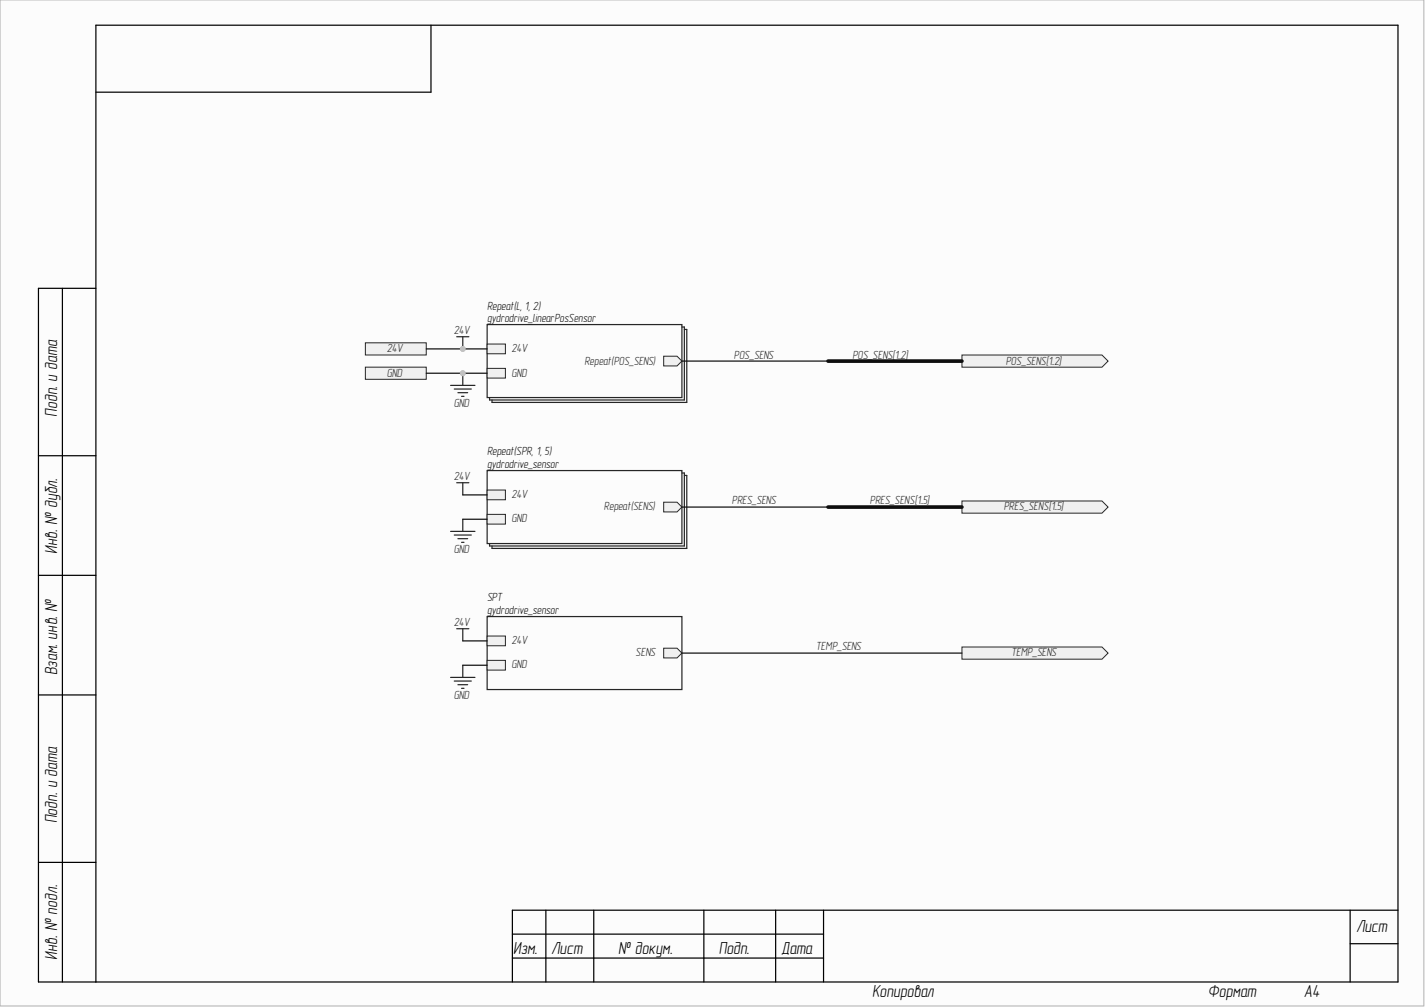
[picture p17: page 17]

Инв. № дубл. Подп. и дата

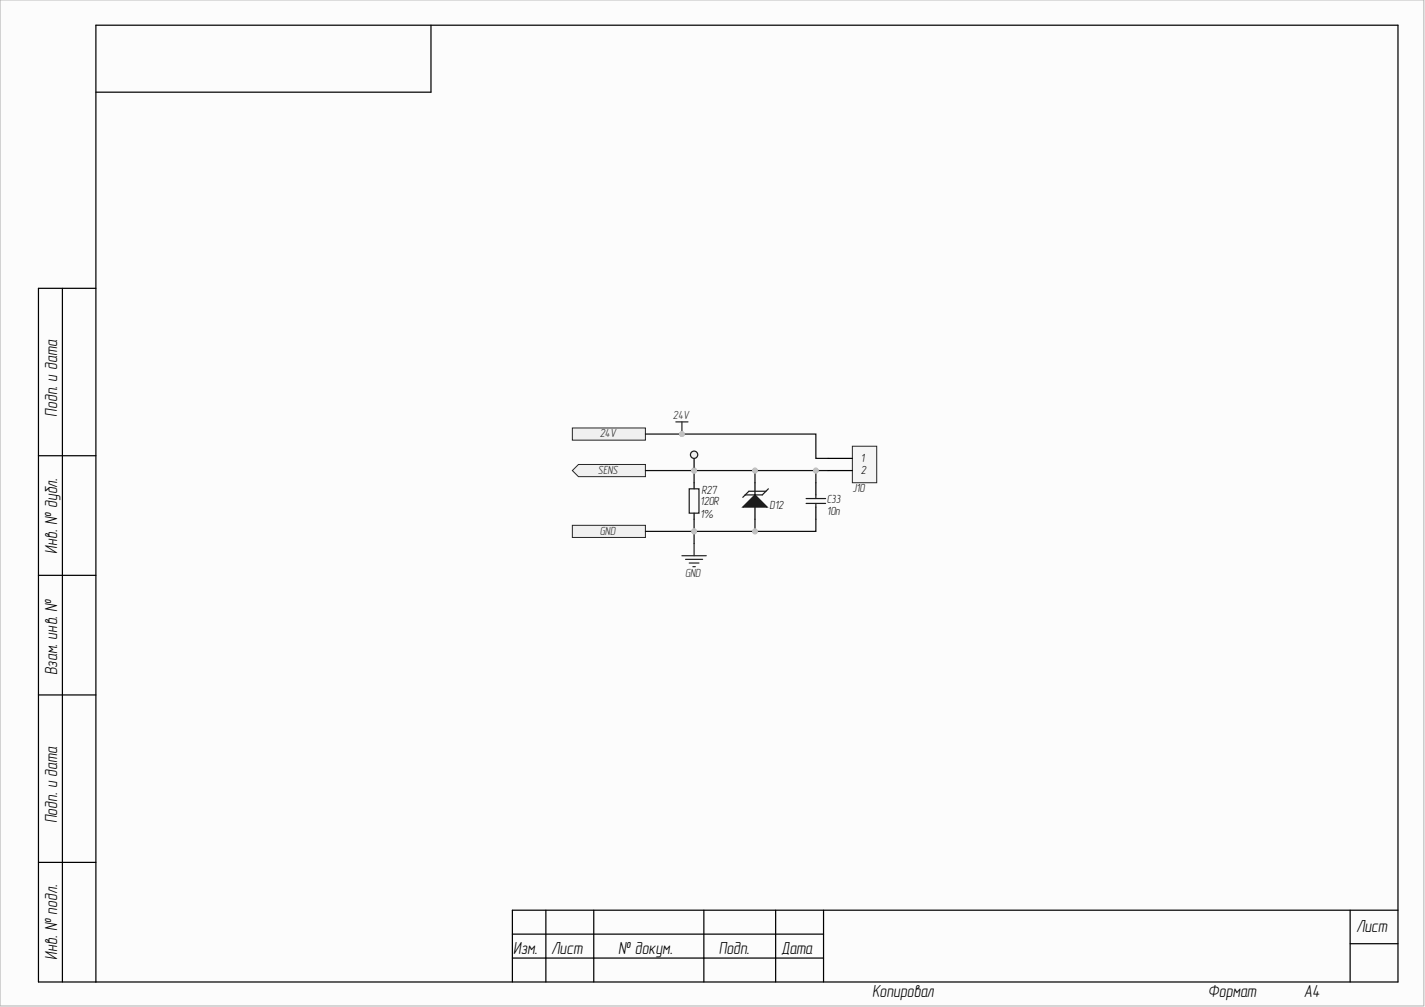
[picture p18: page 18]

Инв. № дубл. Подп. и дата

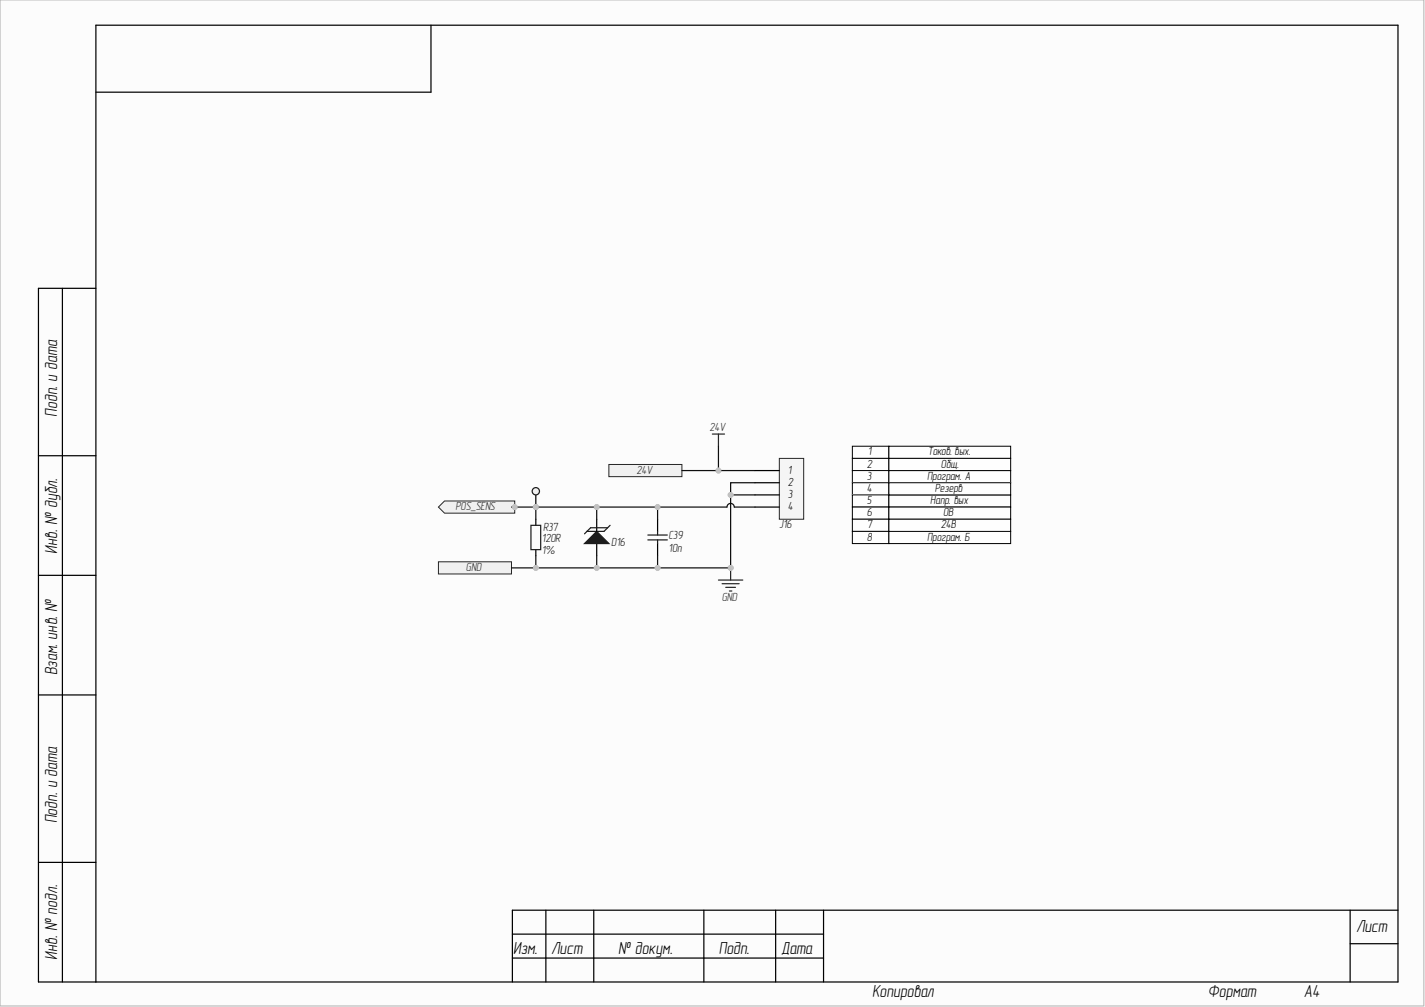
[picture p19: page 19]

Инв. № дубл. Подп. и дата

3 | Програм. А
4 | Резерв
5 | Напр. вых
6 | 0В
7 | 24В
8 | Програм. Б

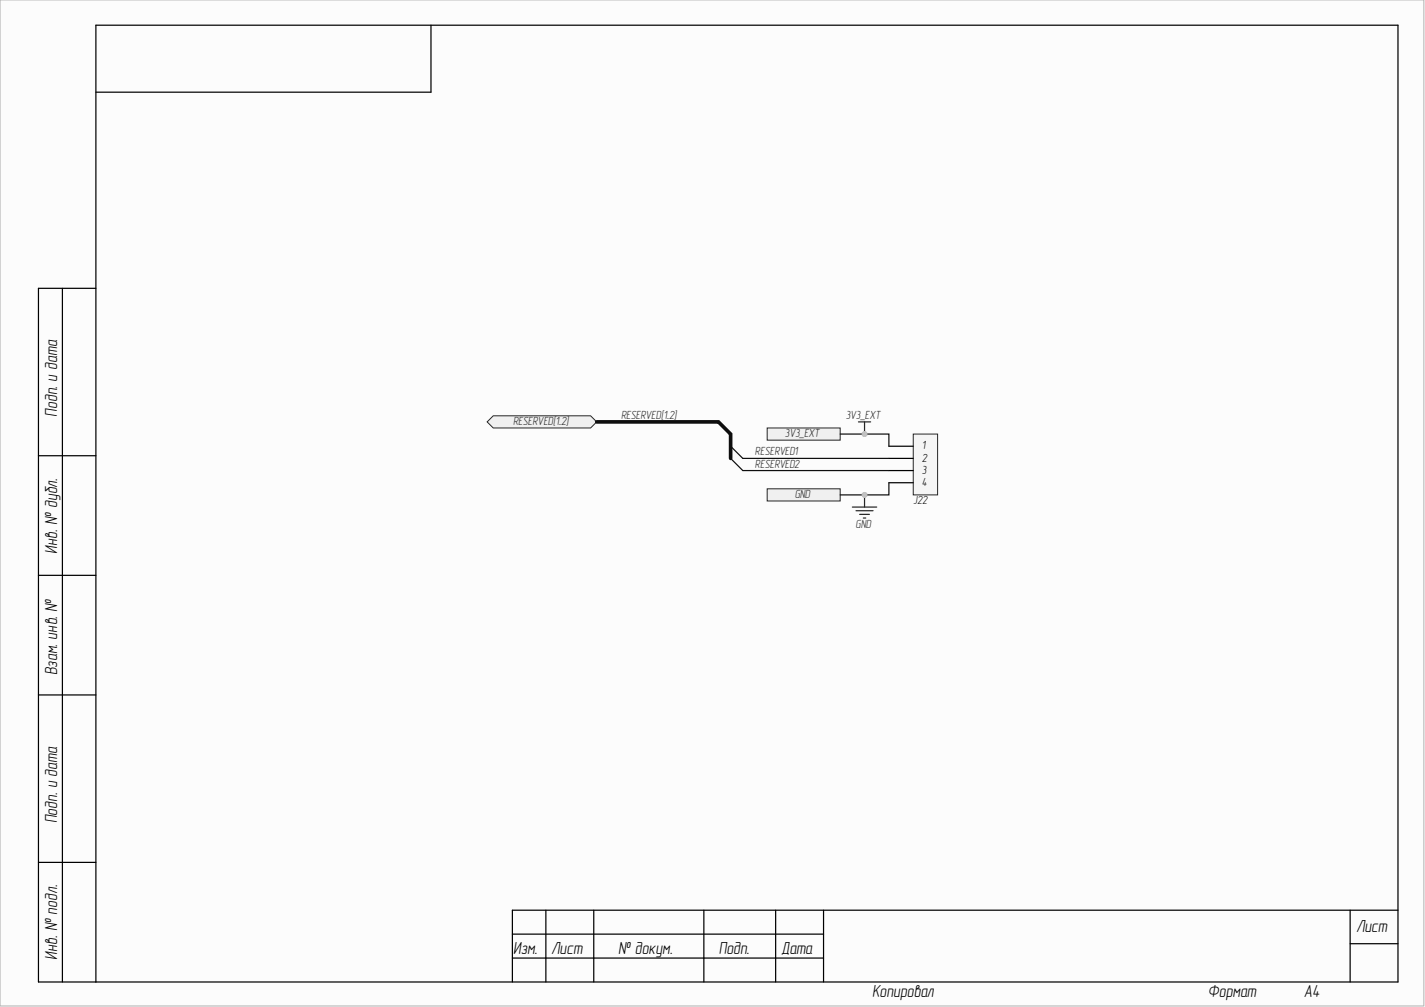
[picture p20: page 20]

Инв. № дубл. Подп. и дата

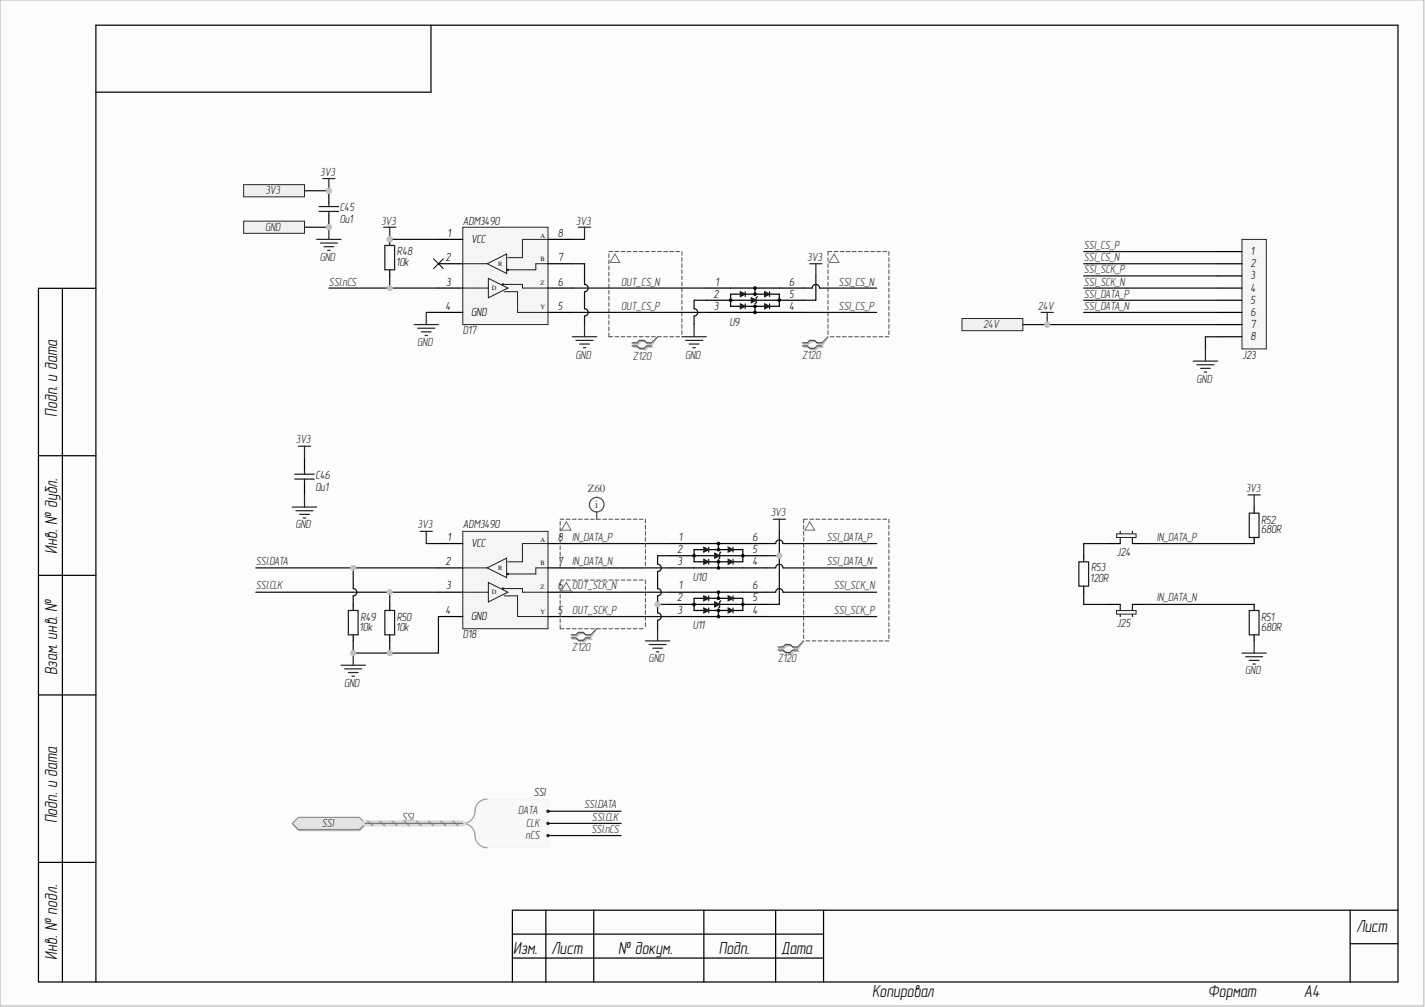
[picture p21: page 21]

Инв. № дубл. Подп. и дата
