klonovvladimir/hydrodrive_pcb/outputs/Плата/Плата.PDF

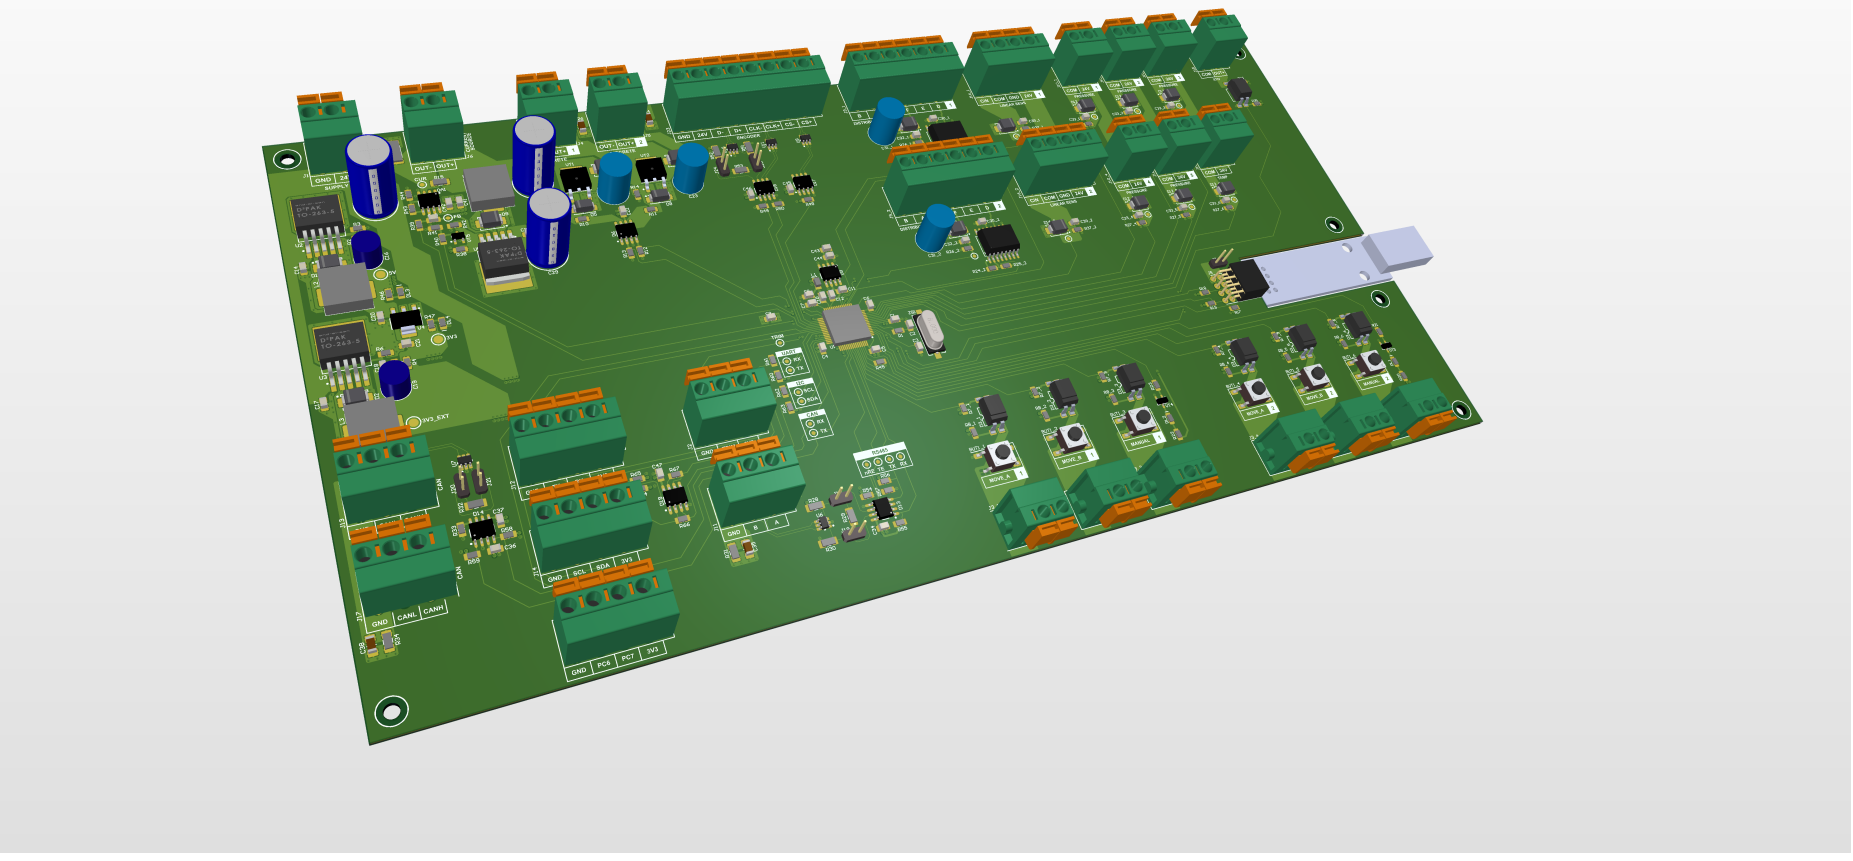
[picture p22: page 1]

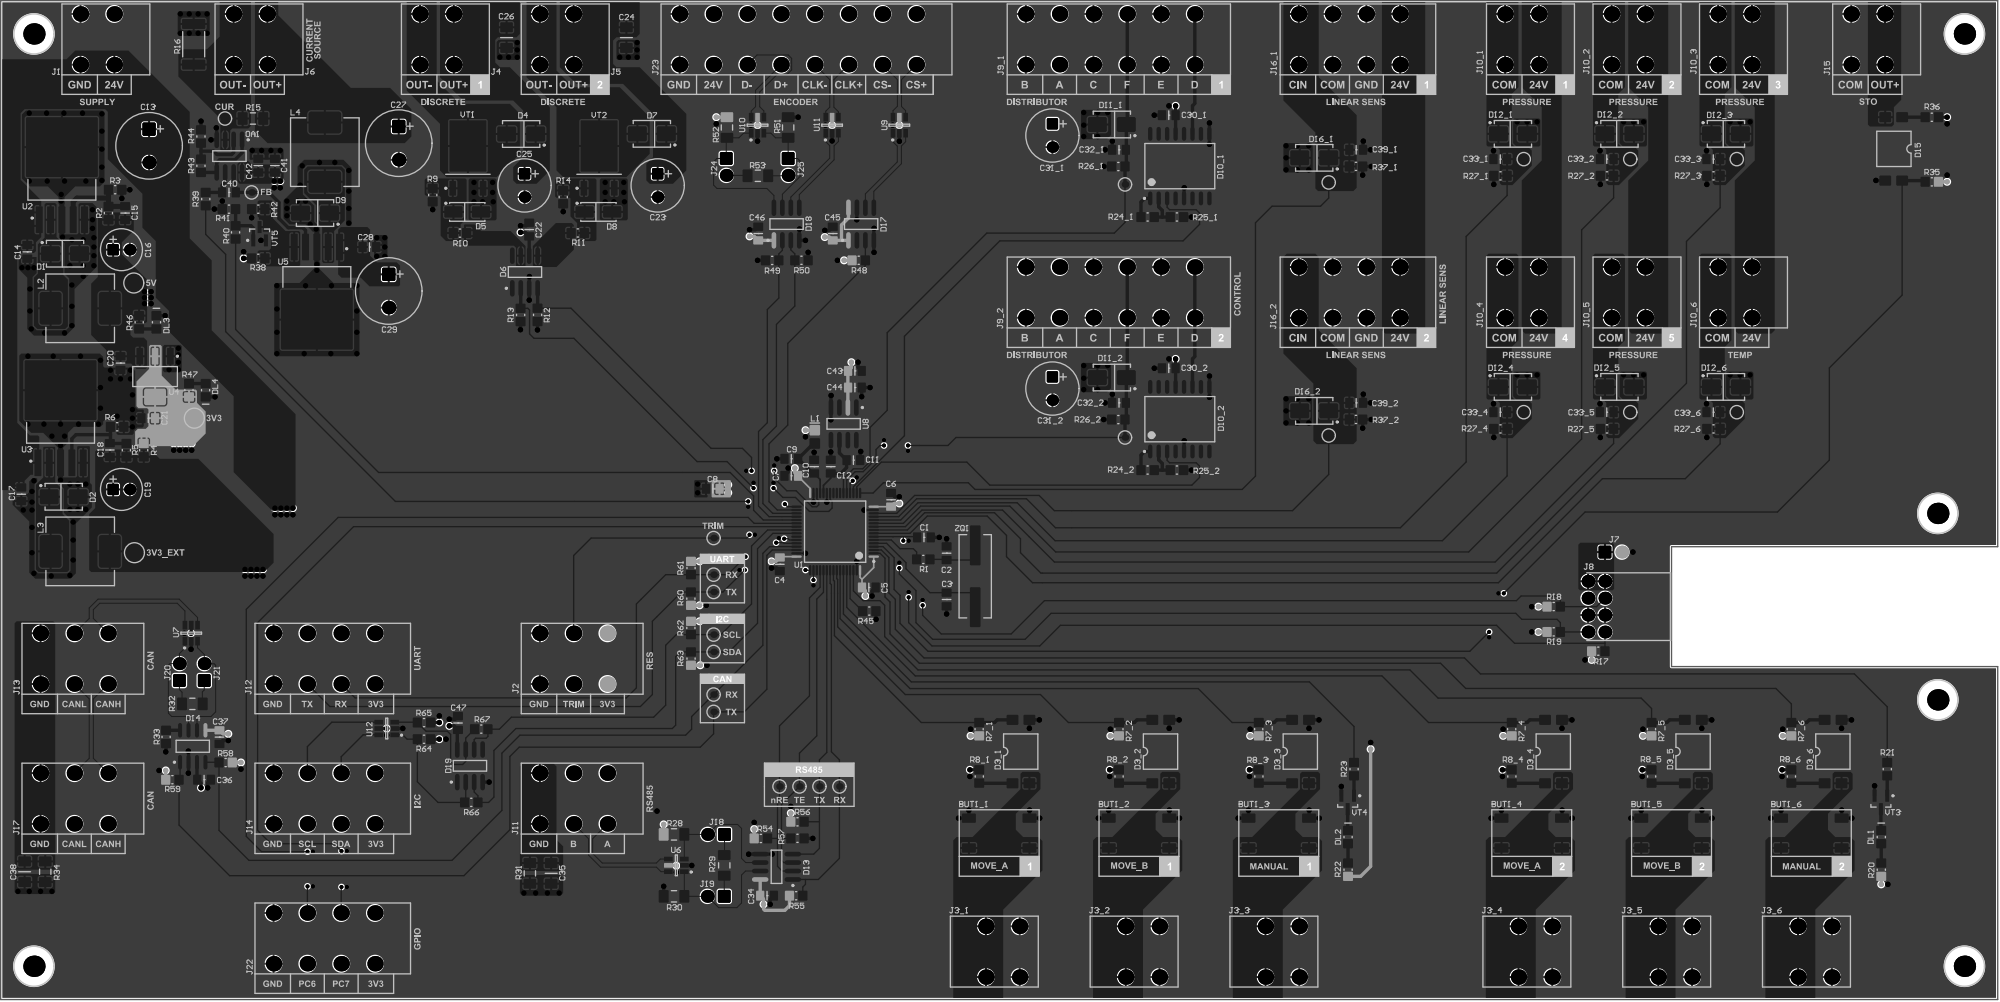
[picture p23: page 2]
