klonovvladimir/hydrodrive_pcb/(list of files, drawings)

Other design files:
gydrodrive_control_board.PrjPcb
schematic/gydrodrive_blockDiagram.SchDoc
schematic/gydrodrive_button.SchDoc
schematic/gydrodrive_can.SchDoc
schematic/gydrodrive_control.SchDoc
schematic/gydrodrive_currentSource.SchDoc
schematic/gydrodrive_debugger.SchDoc
schematic/gydrodrive_discreteControl.SchDoc
schematic/gydrodrive_encoder.SchDoc
schematic/gydrodrive_i2c.SchDoc
schematic/gydrodrive_indication.SchDoc
schematic/gydrodrive_inputTrim.SchDoc
schematic/gydrodrive_interfaces.SchDoc
schematic/gydrodrive_linearPosSensor.SchDoc
schematic/gydrodrive_main.SchDoc
schematic/gydrodrive_mcu.SchDoc
schematic/gydrodrive_reservedPins.SchDoc
schematic/gydrodrive_rs485.SchDoc
schematic/gydrodrive_sensor.SchDoc
schematic/gydrodrive_sensors.SchDoc
schematic/gydrodrive_sto.SchDoc
schematic/gydrodrive_supply.SchDoc
schematic/gydrodrive_uart.SchDoc
