klonovvladimir/hydrodrive_pcb/mxCube mcu pinout/hydrodriveBoard.ioc

Mcu.UserName=STM32G474RETx
PA0.GPIO_Label=SENS_P_4
PA0.Signal=ADC1_IN1
PA1.GPIO_Label=SENS_P_1
PA1.Signal=ADC1_IN2
PA10.Signal=USART1_RX
PA11.Signal=FDCAN1_RX
PA12.Signal=FDCAN1_TX
PA13.Signal=SYS_JTMS-SWDIO
PA14.Signal=SYS_JTCK-SWCLK
PA2.GPIO_Label=LINEAR_SENS_2
PA2.Signal=ADC1_IN3
PA3.GPIO_Label=LINEAR_SENS_1
PA3.Signal=ADC1_IN4
PA4.GPIO_Label=CTRL_2
PA4.Signal=COMP_DAC11_group
PA5.GPIO_Label=CTRL_1
PA5.Signal=COMP_DAC12_group
PA6.GPIO_Label=CS_CTRL
PA6.Signal=COMP_DAC21_group
PA7.GPIO_Label=CTRL_FB_2
PA7.Signal=ADC2_IN4
PA9.Signal=USART1_TX
PB10.GPIO_Label=DISCRETE_CTRL_1
PB10.Signal=GPIO_Output
PB12.Signal=SPI2_NSS
PB13.Signal=SPI2_SCK
PB14.Signal=SPI2_MISO
PB2.GPIO_Label=DISCRETE_CTRL_2
PB2.Signal=GPIO_Output
PB3.GPIO_Label=CH1_MOVE_A_BUT
PB3.Signal=GPIO_Input
PB4.GPIO_Label=CH1_MOVE_B_BUT
PB4.Signal=GPIO_Input
PB5.GPIO_Label=CH1_MANUAL_SET_BUT
PB5.Signal=GPIO_Input
PB6.GPIO_Label=CH1_MANUAL_LED
PB6.Signal=GPIO_Output
PB7.GPIO_Label=CH2_MOVE_A_BUT
PB7.Signal=GPIO_Input
PB9.GPIO_Label=CH2_MOVE_B_BUT
PB9.Signal=GPIO_Input
PC0.GPIO_Label=SENS_T
PC0.Signal=ADC1_IN6
PC1.GPIO_Label=SENS_P_3
PC1.Signal=ADC1_IN7
PC12.GPIO_Label=RS485_TX
PC12.Signal=UART5_TX
PC13.GPIO_Label=CH2_MANUAL_SET_BUT
PC13.Signal=GPIO_Input
PC14-OSC32_IN.GPIO_Label=CH2_MANUAL_LED
PC14-OSC32_IN.Signal=GPIO_Output
PC15-OSC32_OUT.GPIO_Label=STO
PC15-OSC32_OUT.Signal=GPIO_Input
PC2.GPIO_Label=SENS_P_5
PC2.Signal=ADC1_IN8
PC3.GPIO_Label=SENS_P_2
PC3.Signal=ADC1_IN9
PC4.GPIO_Label=CTRL_FB_1
PC4.Signal=ADC2_IN5
PC8.Signal=I2C3_SCL
PC9.Signal=I2C3_SDA
PD2.GPIO_Label=RX485_RX
PD2.Signal=UART5_RX
PF0-OSC_IN.Signal=RCC_OSC_IN
PF1-OSC_OUT.Signal=RCC_OSC_OUT
